GaryRudolph/N877RV/electrical/electrical-Cables.pdf

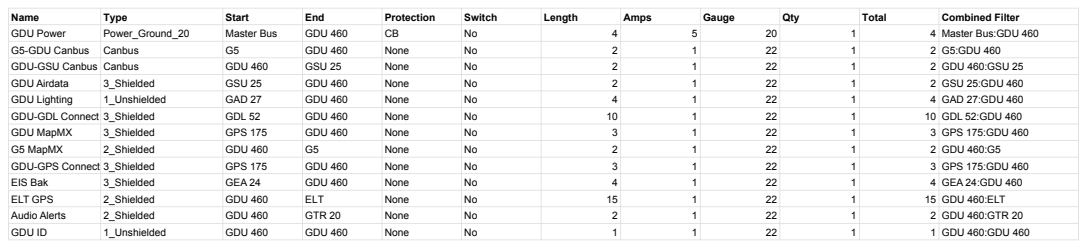
[picture p1: page 1]
Name; Type; Start; End; Protection; Switch; Length; Amps; Gauge; Qty; Total; Combined Filter; GDU Power; Power_Ground_20; Master Bus; GDU 460; 4 Master Bus:GDU 460; G5-GDU Canbus; Canbus; None; 2 G5:GDU 460; GDU-GSU Canbus Canbus; GSU 25; 2 GDU 460:GSU 25; GDU Airdata; 3_Shielded; 2 GSU 25:GDU 460; GDU Lighting; 1_Unshielded; GAD 27; 4 GAD 27:GDU 460; GDU-GDL Connect 3_Shielded; GDL 52; 10 GDL 52:GDU 460; GDU MapMX; GPS 175; 3 GPS 175:GDU 460; G5 MapMX; 2_Shielded; 2 GDU 460:G5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

Name | Type | Start | End | Protection | Switch | Length | Amps | Gauge | Qty | Total | Combined Filter
G5 Power | Power_Ground_20 | Avionics Bus | G5 | CB | No | 4 | 5 | 20 | 1 | 4 | Avionics Bus:G5
GSA-G5 Canbus | Canbus | GSA 28 Pitch | G5 | None | No | 15 | 1 | 22 | 1 | 15 | GSA 28 Pitch:G5
G5-GDU Canbus | Canbus | G5 | GDU 460 | None | No | 2 | 1 | 22 | 1 | 2 | G5:GDU 460
G5 MapMX | 2_Shielded | GDU 460 | G5 | None | No | 2 | 1 | 22 | 1 | 2 | GDU 460:G5

Name | Type | Start | End | Protection | Switch | Length | Amps | Gauge | Qty | Total | Combined Filter
GSU 25 Power | Power_Ground_22 | Master Bus | GSU 25 | CB | No | 4 | 2 | 22 | 1 | 4 | Master Bus:GSU 25
GDU-GSU Canbus | Canbus | GDU 460 | GSU 25 | None | No | 2 | 1 | 22 | 1 | 2 | GDU 460:GSU 25
GSU-GTR Canbus | Canbus | GSU 25 | GTR 20 | None | No | 2 | 1 | 22 | 1 | 2 | GSU 25:GTR 20
GTP 59 Cable | 3_Shielded | GSU 25 | GTP 59 | None | No | 10 | 1 | 22 | 1 | 10 | GSU 25:GTP 59
TX Airdata | 2_Shielded | GSU 25 | GTX 320 | None | No | 3 | 1 | 22 | 1 | 3 | GSU 25:GTX 320
GDU Airdata | 3_Shielded | GSU 25 | GDU 460 | None | No | 2 | 1 | 22 | 1 | 2 | GSU 25:GDU 460

Name | Type | Start | End | Protection | Switch | Length | Amps | Gauge | Qty | Total | Combined Filter
GSA 28 Roll Power | Power_Ground_18 | Avionics Bus | GSA 28 Roll [1] | CB | No | 15 | 5 | 18 | 1 | 15 | Avionics Bus:GSA 28 Roll
GSA 28 Pitch PowerPower_Ground_18 | | Avionics Bus | GSA 28 Pitch [2] | CB | No | 15 | 5 | 18 | 1 | 15 | Avionics Bus:GSA 28 Pitch
GMU-GSA Canbus | Canbus | GMU 11 | GSA 28 Pitch | None | No | 3 | 1 | 22 | 1 | 3 | GMU 11:GSA 28 Pitch
GSA-G5 Canbus | Canbus | GSA 28 Pitch | G5 | None | No | 15 | 1 | 22 | 1 | 15 | GSA 28 Pitch:G5
GAD27-GSA CanbusCanbus | | GAD 27 | GSA 28 Roll | None | No | 15 | 1 | 22 | 1 | 15 | GAD 27:GSA 28 Roll
CWS Disconnect | 1_Unshielded | Panel | GSA 28 | None | No | 10 | 1 | 22 | 2 | 20 | Panel:GSA 28

Name | Type | Start | End | Protection | Switch | Length | Amps | Gauge | Qty | Total | Combined Filter
GMU 11 Power | Power_Ground_22 | Master Bus | GMU 11 [1] | CB | No | 15 | 2 | 22 | 1 | 15 | Master Bus:GMU 11
GMU-GSA Canbus | Canbus | GMU 11 | GSA 28 Pitch | None | No | 3 | 1 | 22 | 1 | 3 | GMU 11:GSA 28 Pitch

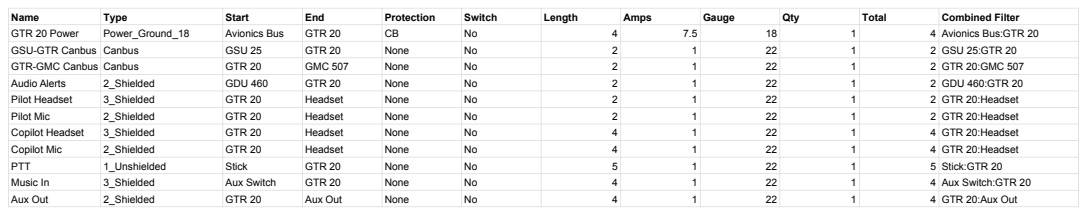
[picture p2: page 6]
Name; Type; Start; End; Protection; Switch; Length; Amps; Gauge; Qty; Total; Combined Filter; GTR 20 Power; Power_Ground_18; Avionics Bus; GTR 20; 4 Avionics Bus:GTR 20; GSU-GTR Canbus Canbus; GSU 25; None; 2 GSU 25:GTR 20; GTR-GMC Canbus Canbus; GMC 507; 2 GTR 20:GMC 507; Audio Alerts; 2_Shielded; GDU 460; 2 GDU 460:GTR 20; Pilot Headset; 3_Shielded; Headset; 2 GTR 20:Headset; Pilot Mic; Copilot Headset; 4 GTR 20:Headset; Copilot Mic; PTT; 1_Unshielded; Stick; 5 Stick:GTR 20; Music In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

Name | Type | Start | End | Protection | Switch | Length | Amps | Gauge | Qty | Total | Combined Filter
GMC 507 Power | Power_Ground_22 | Avionics Bus | GMC 507 | Fuse | No | 2 | 1 | 22 | 1 | 2 | Avionics Bus:GMC 507
GTR-GMC Canbus | Canbus | GTR 20 | GMC 507 | None | No | 2 | 1 | 22 | 1 | 2 | GTR 20:GMC 507
GMC-GAD29 CanbusCanbus | | GMC 507 | GAD 29 | None | No | 2 | 1 | 22 | 1 | 2 | GMC 507:GAD 29
GMC Light | 1_Unshielded | GAD 27 | GMC 507 | None | No | 3 | 1 | 22 | 1 | 3 | GAD 27:GMC 507

3 Avionics Bus:GPS 175
3 GPS 175:GDU 460
3 GAD 27:GPS 175

Name | Type | Start | End | Protection | Switch | Length | Amps | Gauge | Qty | Total | Combined Filter
GAD 29 Power | Power_Ground_20 | Avionics Bus | GAD 29 | CB | No | 3 | 5 | 20 | 1 | 3 | Avionics Bus:GAD 29
GMC-GAD29 CanbusCanbus | | GMC 507 | GAD 29 | None | No | 2 | 1 | 22 | 1 | 2 | GMC 507:GAD 29
GAD29-GEA CanbusCanbus | | GAD 29 | GEA 24 | None | No | 2 | 1 | 22 | 1 | 2 | GAD 29:GEA 24
ARINC | Cat_5 | GPS 175 | GAD 29 | None | No | 2 | 1 | 22 | 2 | 4 | GPS 175:GAD 29

Name | Type | Start | End | Protection | Switch | Length | Amps | Gauge | Qty | Total | Combined Filter
GTX 320 Power | Power_Ground_18 | Avionics Bus | GTX 320 | CB | No | 2 | 3 | 18 | 1 | 2 | Avionics Bus:GTX 320
TX Airdata | 2_Shielded | GSU 25 | GTX 320 | None | No | 3 | 1 | 22 | 1 | 3 | GSU 25:GTX 320
GTX Light | 1_Unshielded | GAD 27 | GTX 320 | None | No | 3 | 1 | 22 | 1 | 3 | GAD 27:GTX 320
Grey Code | 10_Shielded | Alt Encoder | GTX 320 | None | No | 2 | 1 | 22 | 1 | 2 | Alt Encoder:GTX 320

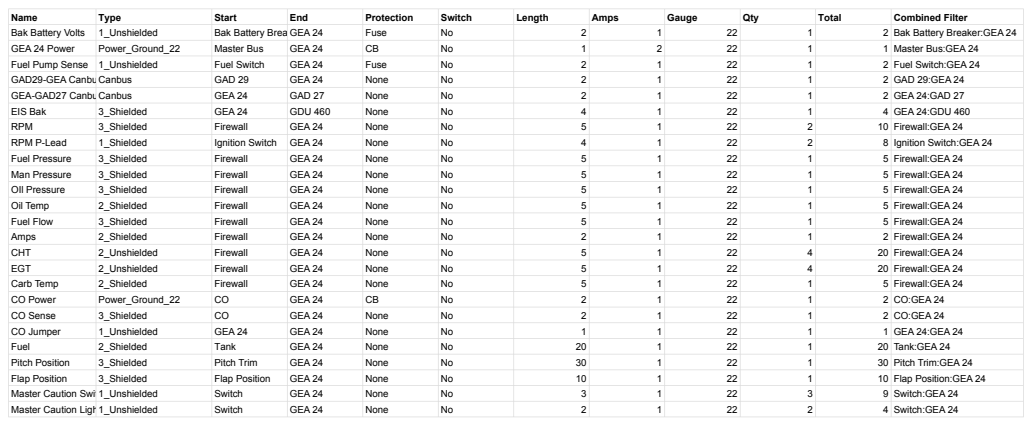
[picture p3: page 11]
Name; Type; Start; End; Protection; Switch; Length; Amps; Gauge; Qty; Total; Combined Filter; Bak Battery Volts; 1_Unshielded; Bak Battery Breaker GEA 24; Fuse; 2 Bak Battery Breaker:GEA 24; GEA 24 Power; Power_Ground_22; Master Bus; GEA 24; 1 Master Bus:GEA 24; Fuel Pump Sense 1_Unshielded; Fuel Switch; 2 Fuel Switch:GEA 24; GAD29-GEA CanbusCanbus; GAD 29; None; 2 GAD 29:GEA 24; GEA-GAD27 CanbusCanbus; GAD 27; 2 GEA 24:GAD 27; EIS Bak; 3_Shielded; GDU 460; 4 GEA 24:GDU 460; RPM; Firewall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

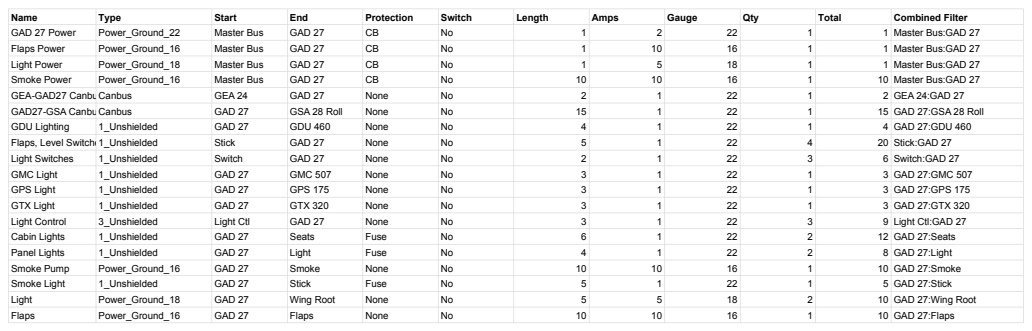
[picture p4: page 12]
Name; Type; Start; End; Protection; Switch; Length; Amps; Gauge; Qty; Total; Combined Filter; GAD 27 Power; Power_Ground_22; Master Bus; GAD 27; 1 Master Bus:GAD 27; Flaps Power; Power_Ground_16; Light Power; Power_Ground_18; Smoke Power; 10 Master Bus:GAD 27; GEA-GAD27 CanbusCanbus; GEA 24; None; 2 GEA 24:GAD 27; GAD27-GSA CanbusCanbus; GSA 28 Roll; 15 GAD 27:GSA 28 Roll; GDU Lighting; 1_Unshielded; GDU 460; 4 GAD 27:GDU 460; Flaps, Level Switches1_Unshielded; Stick; 20 Stick:GAD 27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

Name | Type | Start | End | Protection | Switch | Length | Amps | Gauge | Qty | Total | Combined Filter
GDL 52 Power | Power_Ground_20 | Avionics Bus | GDL 52 [1] | CB | No | 10 | 3 | 20 | 1 | 10 | Avionics Bus:GDL 52
GDU-GDL Connect | 3_Shielded | GDL 52 | GDU 460 | None | No | 10 | 1 | 22 | 1 | 10 | GDL 52:GDU 460
Siriux In | 3_Shielded | GDL 52 | Aux Switch | None | No | 15 | 1 | 22 | 1 | 15 | GDL 52:Aux Switch
GPS GDL Connect | 3_Shielded | GDL 52 | GPS 175 | None | No | 15 | 1 | 22 | 1 | 15 | GDL 52:GPS 175
