GaryRudolph/N877RV/electrical/electrical.pdf

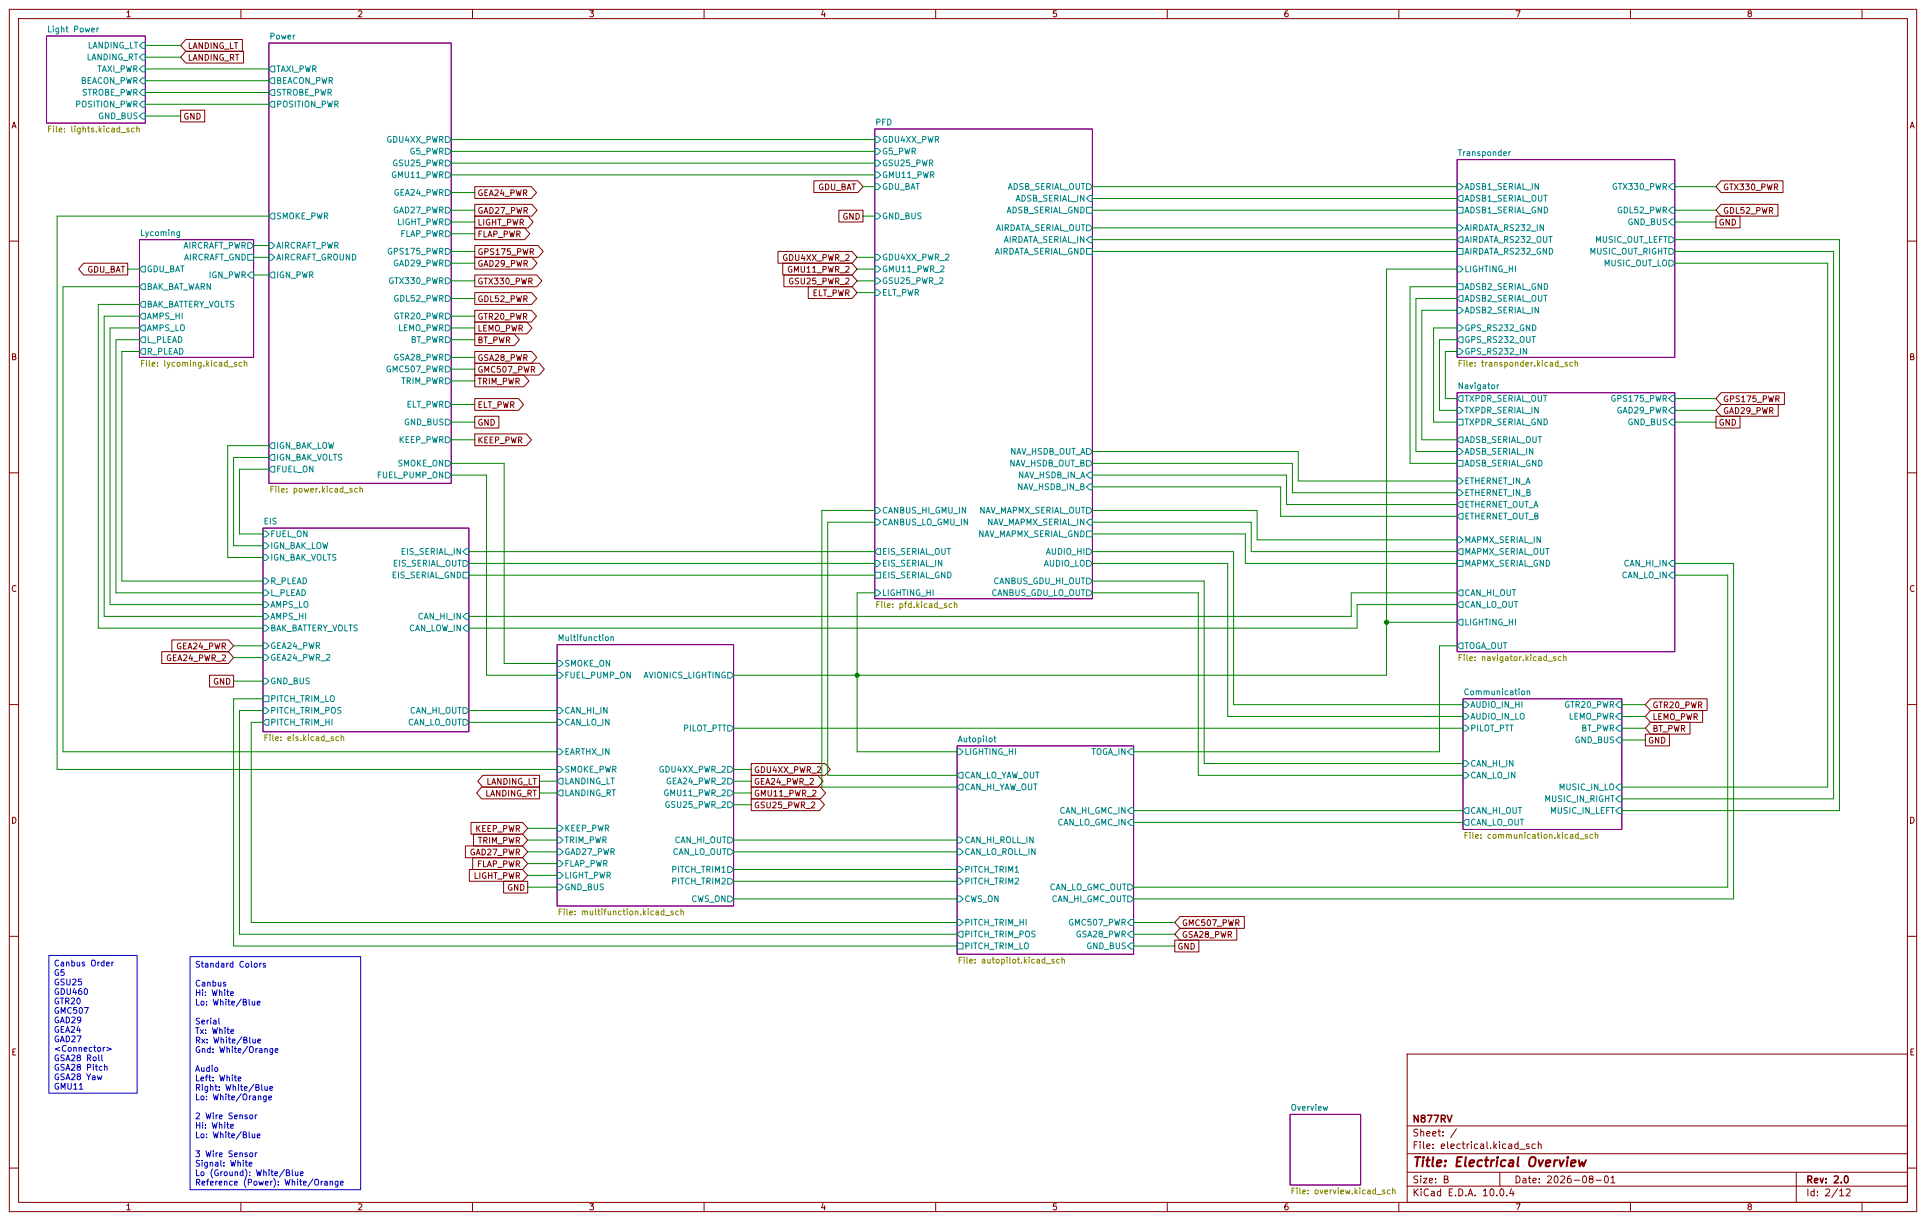
[picture p5: page 1]

Light Power File: lights.kicad_sch
LANDING_LT LANDING_RT POSITION_PWR

Lo (Ground): White/Blue Reference (Power): White/Orange Canbus Order G5GSU25 GDU460 GTR20 GMC507 GAD29 GEA24 GAD27 <Connector>

Standard Colors Canbus Hi: White

Lo: White/Blue Serial Tx: White Rx: White/Blue Gnd: White/Orange

Audio
Left: White Right: White/Blue

Lo: White/Orange 2 Wire Sensor Hi: White

Lo: White/Blue 3 Wire Sensor Signal: White

Size: B | Rev: 2.0
KiCad E.D.A. 10.0.4 | Id: 2/12

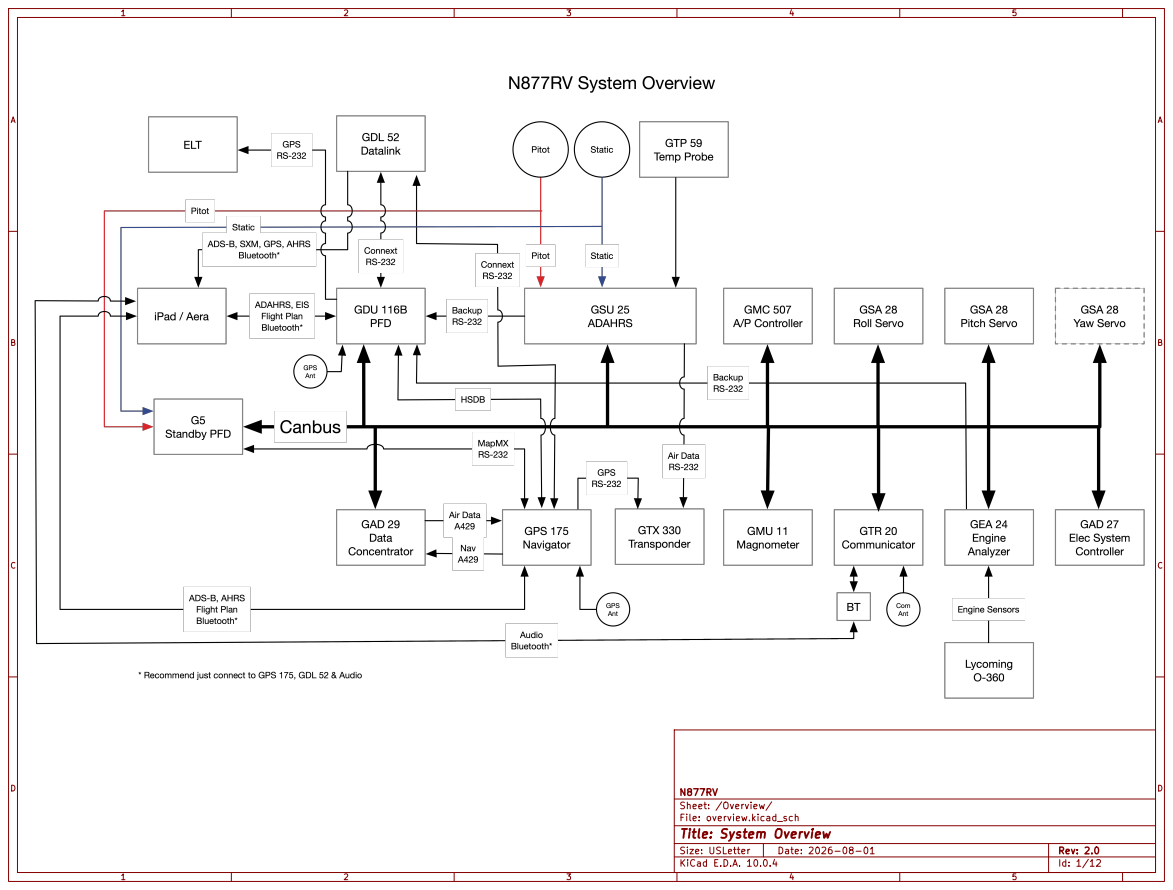
[picture p6: page 2]

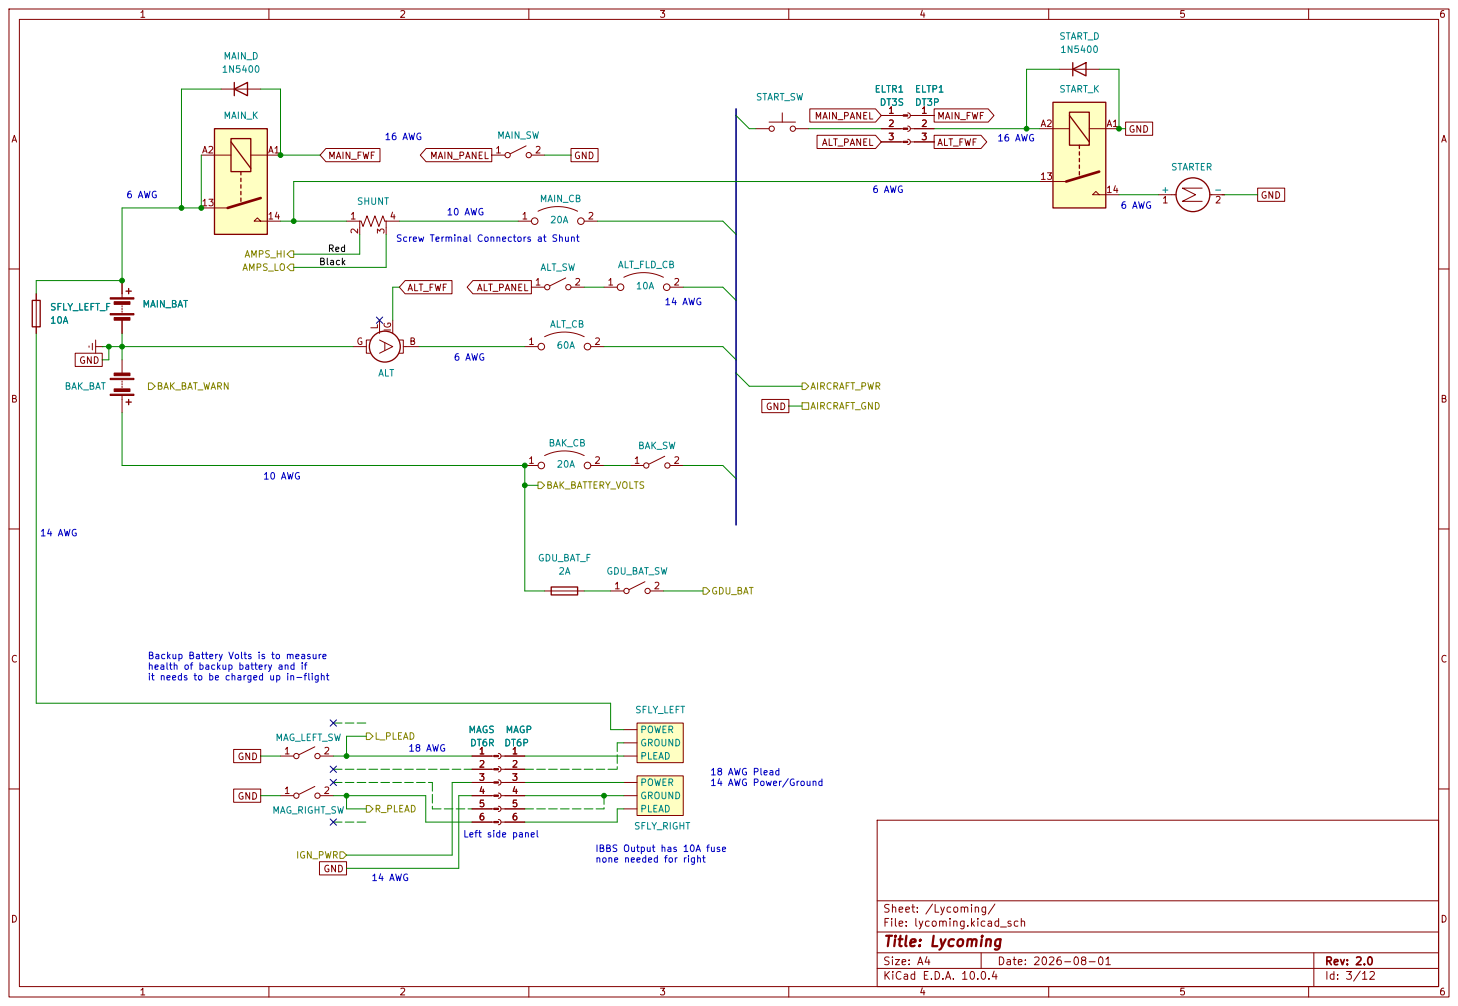
[picture p7: page 3]

Screw Terminal Connectors at Shunt

Backup Battery Volts is to measure health of backup battery and if

IBBS Output has 10A fuse none needed for right

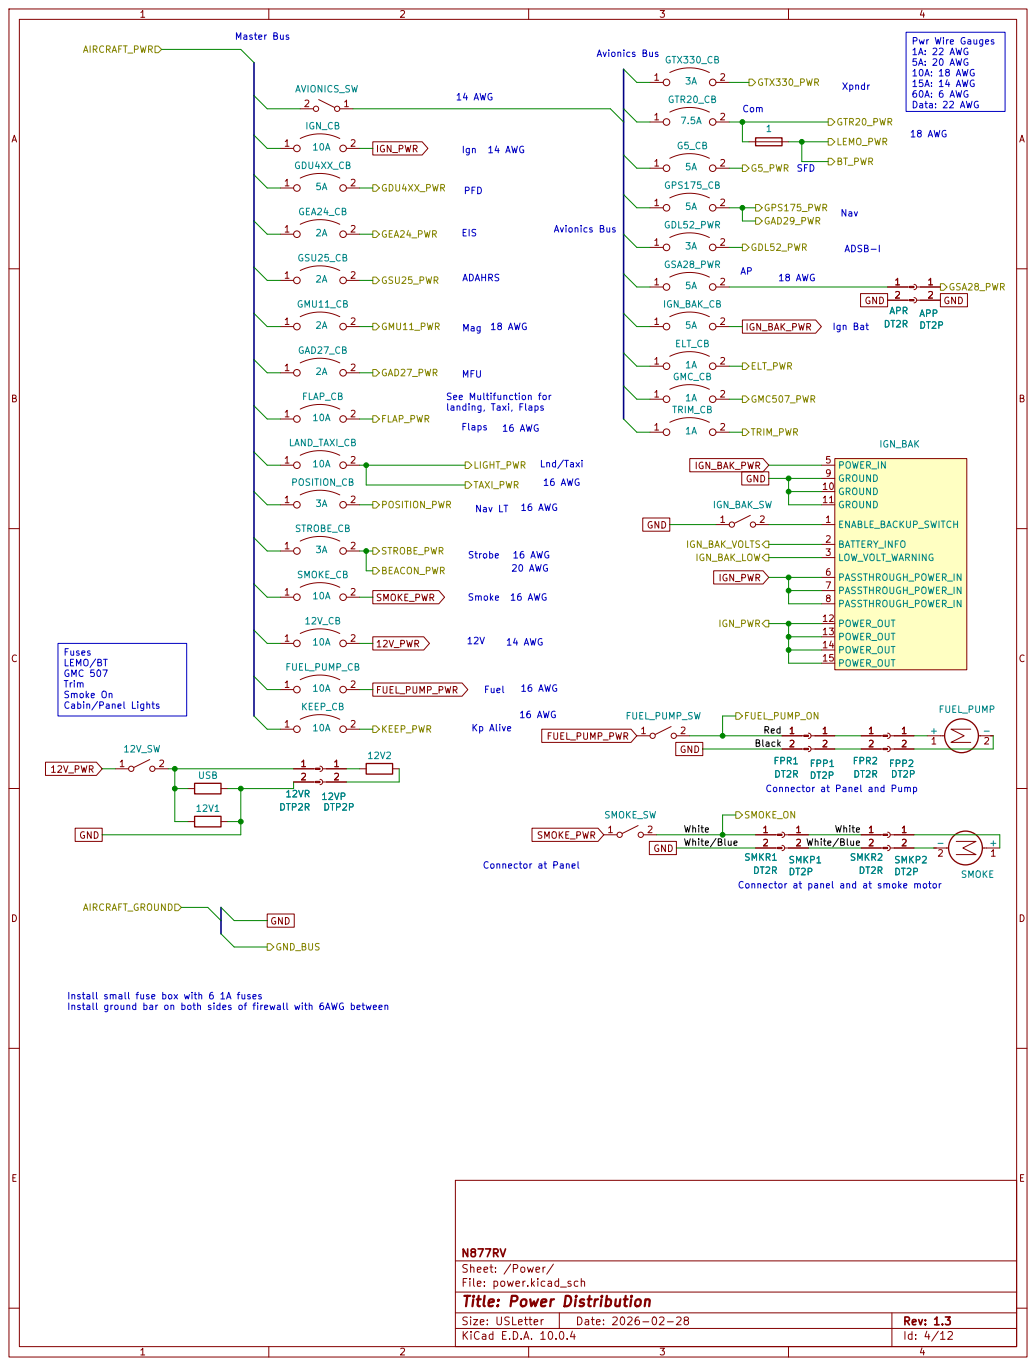
[picture p8: page 4]

Pwr Wire Gauges 1A: 22 AWG

GSU25_PWR
Kp Alive Connector at Panel 16 AWG
TAXI_PWR

Trim
Smoke On Cabin/Panel Lights

Connector at Panel and Pump

Install small fuse box with 6 1A fuses
Install ground bar on both sides of firewall with 6AWG between

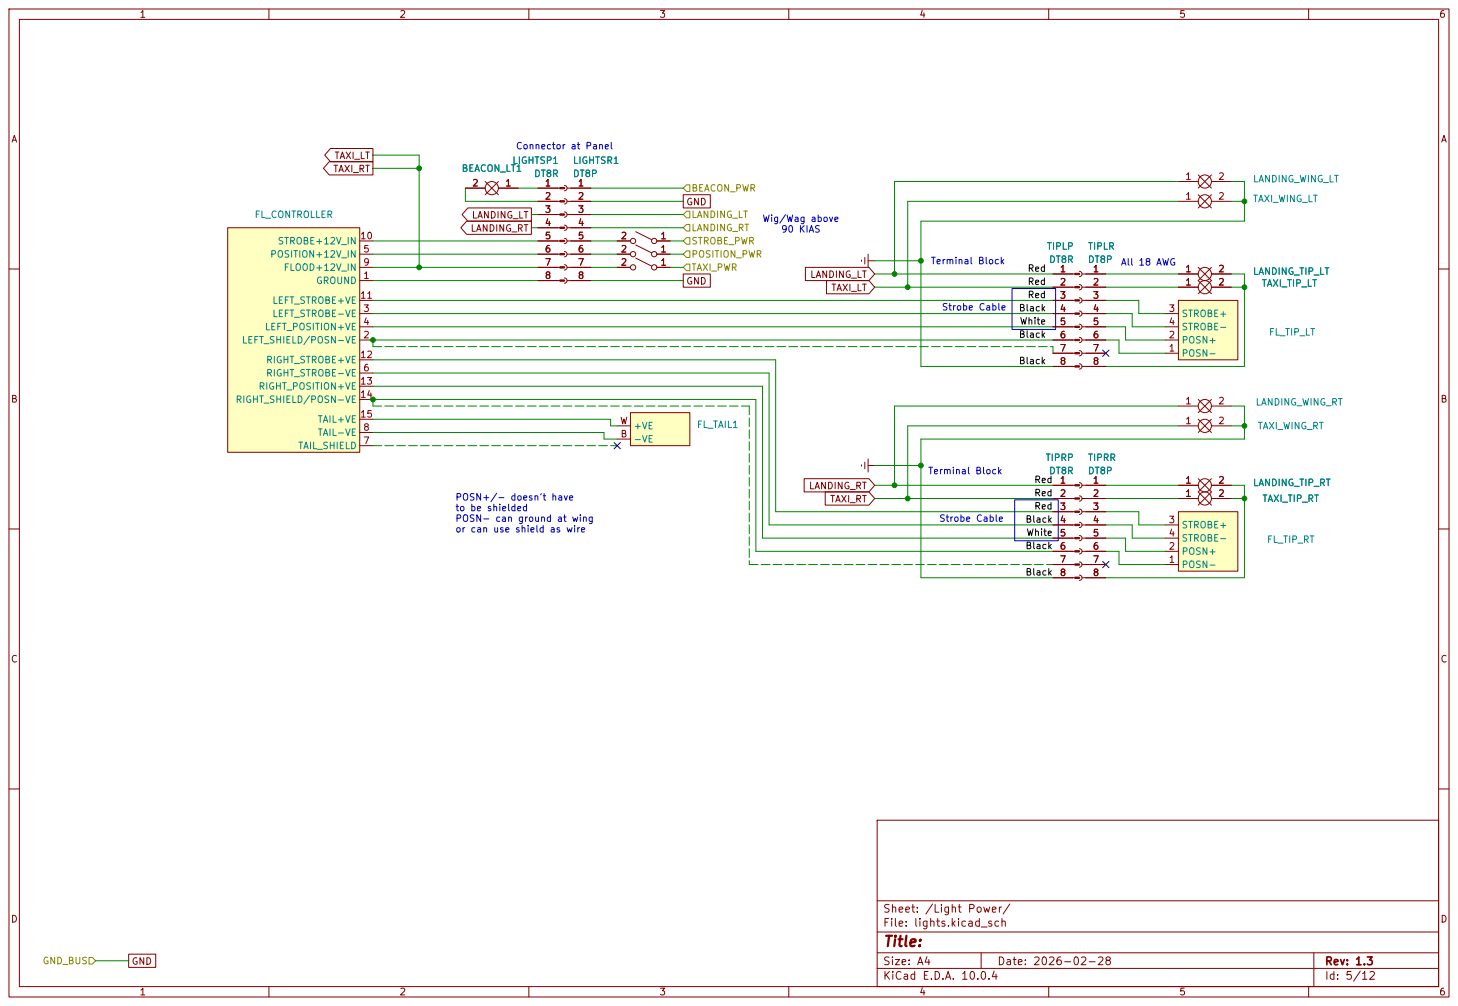
[picture p9: page 5]

LEFT_STROBE+VE 11 RIGHT_STROBE+VE 12 RIGHT_POSITION+VE 13 RIGHT_SHIELD/POSN-VE 14

Terminal Block POSN+/- doesn't have

to be shielded POSN- can ground at wing

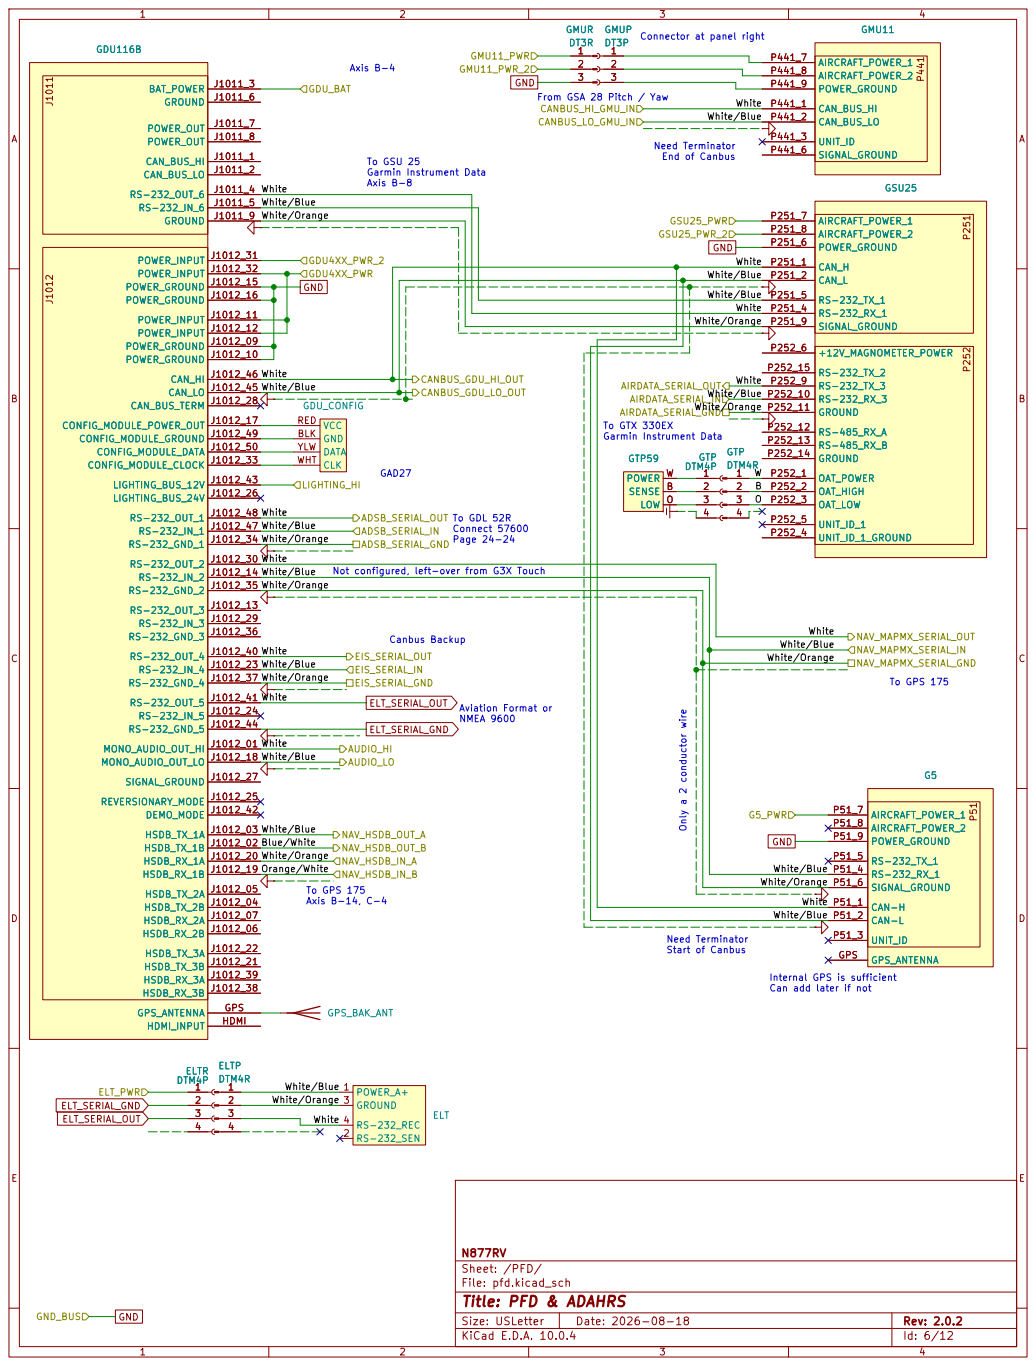
[picture p10: page 6]

To GSU 25 Garmin Instrument Data

ELT_SERIAL_OUT White/Blue White White White/Blue

To GDL 52R
Connect 57600 Page 24-24
White/Orange White White/BlueWhite White/Blue

Internal GPS is sufficient Can add later if not Canbus Backup Not configured, left-over from G3X Touch

Aviation Format or NMEA 9600

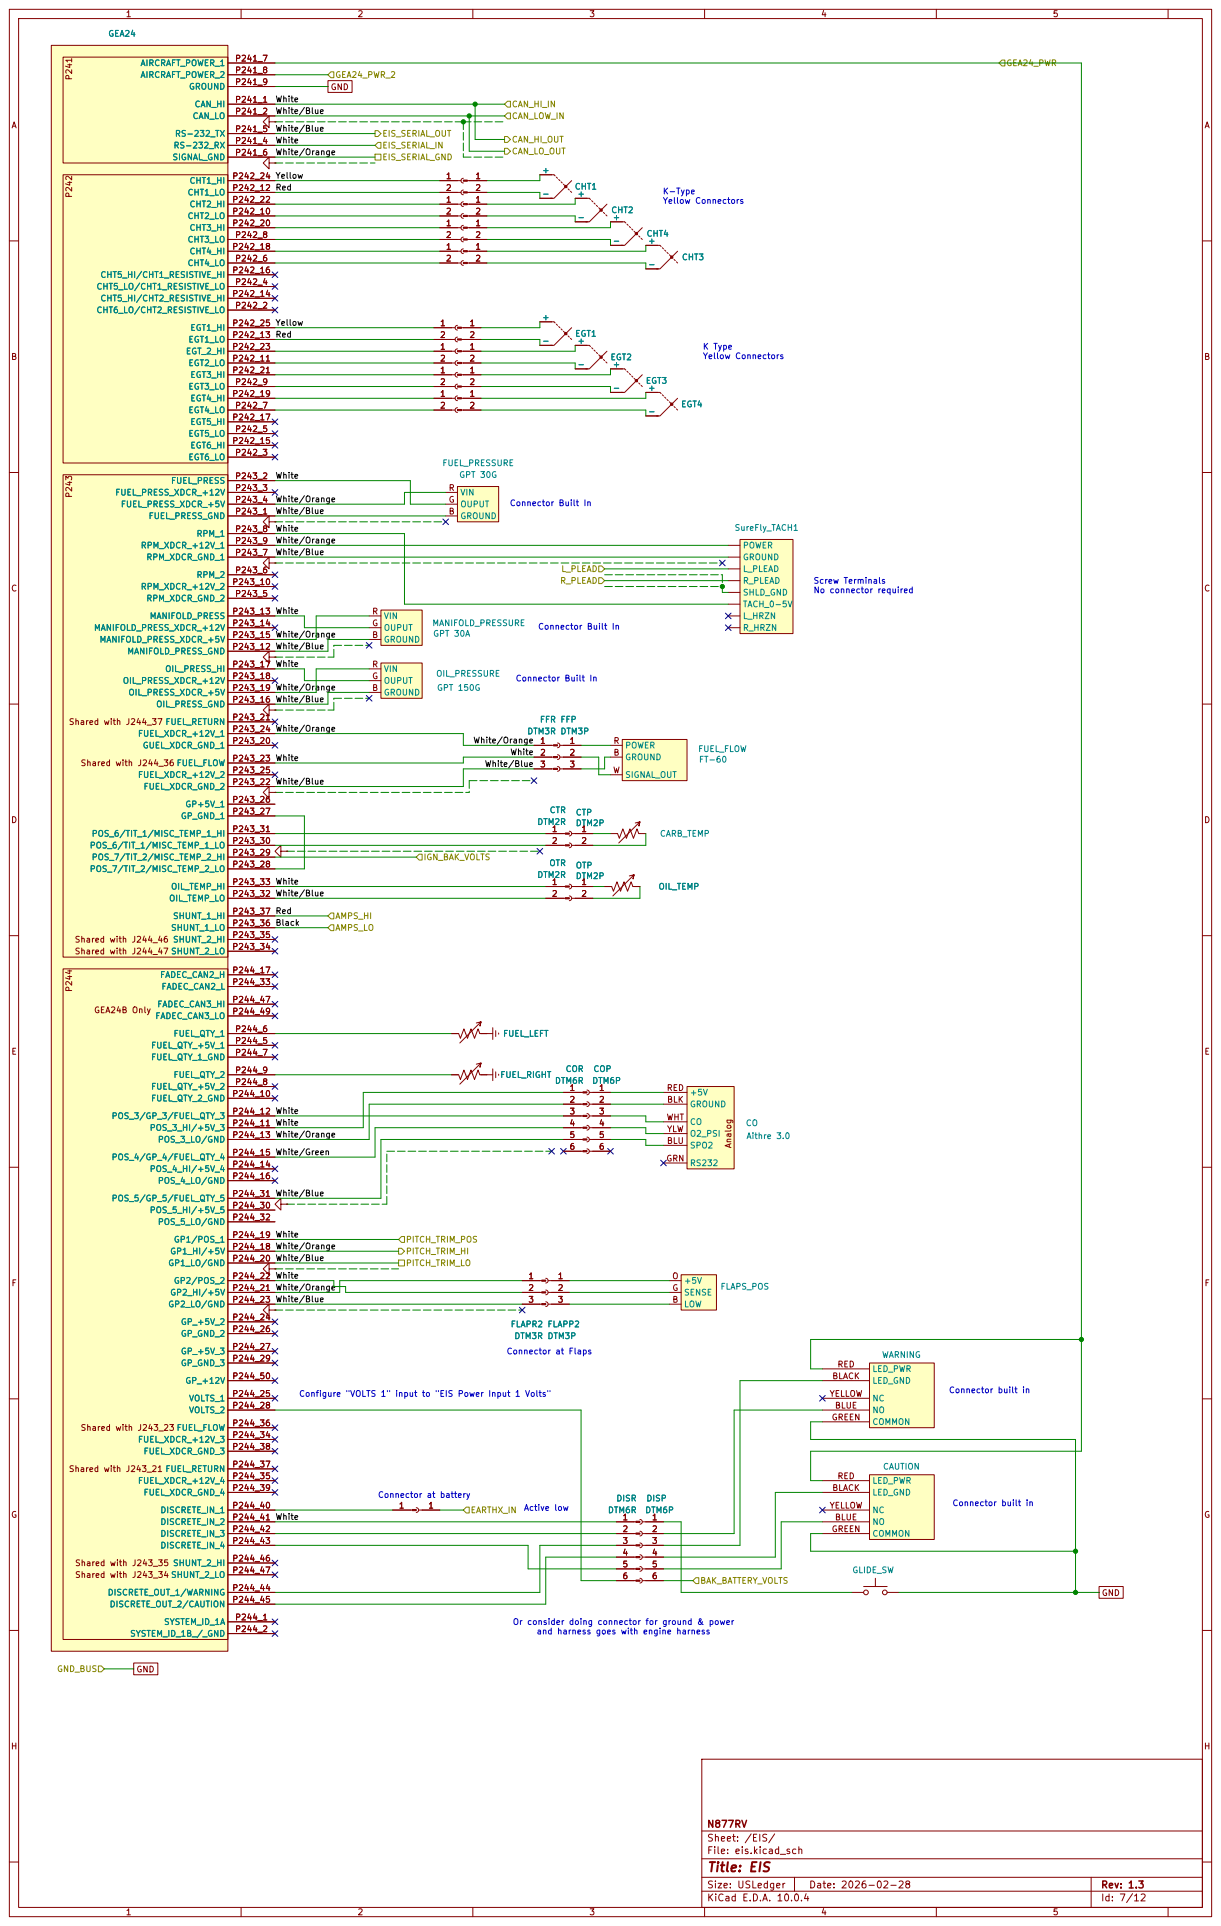
[picture p11: page 7]

L_PLEAD | WARNING P241 P242 P243 P244 Shared with J243_35

Yellow White/Orange White
White/Blue
White/Blue White Red

White/Blue White White/Orange White

White/Blue White White/Orange

White/Blue White Red Black White White/Orange

White White/Orange White
White/Orange

Connector built in Connector at battery

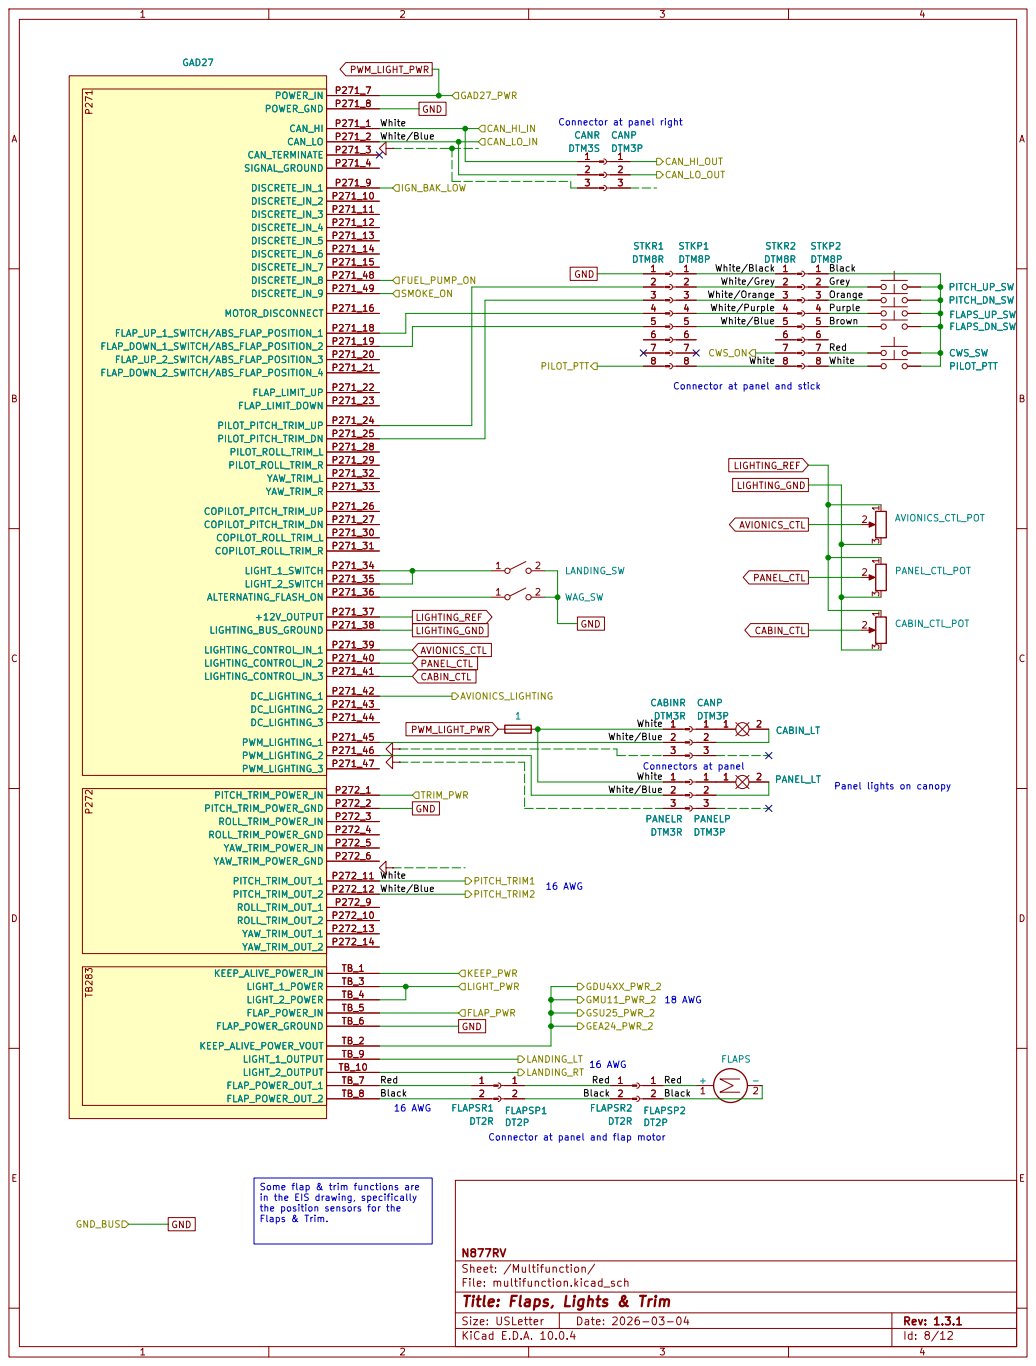
[picture p12: page 8]

Connector at panel right Connectors at panel 16 AWG
White

Connector at panel and stick

Some flap & trim functions are
in the EIS drawing, specifically
the position sensors for the

Sheet: /Multifunction/
File: multifunction.kicad_sch
Title: Flaps, Lights & Trim

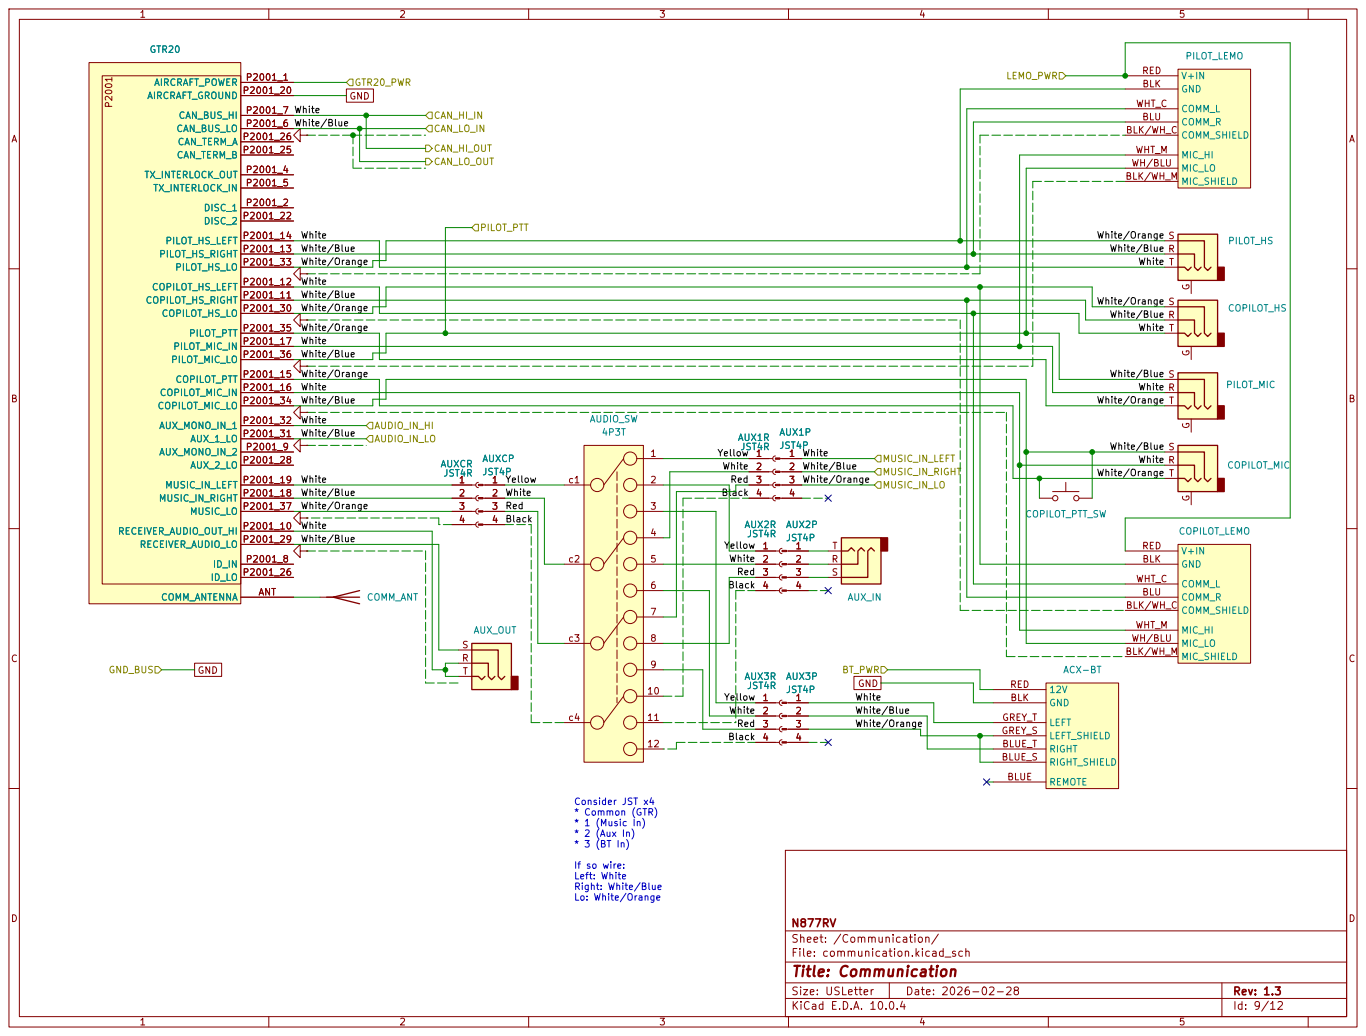
[picture p13: page 9]

White/Blue White White/Blue White White White/Orange

White/Blue White White White/Orange

White/Orange White White/Orange

COMM_L WHT_C MIC_HI WHT_M COMM_R BLU

COMM_SHIELD BLK/WH_C MIC_SHIELD BLK/WH_M

* Common (GTR) * 1 (Music In) * 2 (Aux In) * 3 (BT

If so wire: Left: White Right: White/Blue

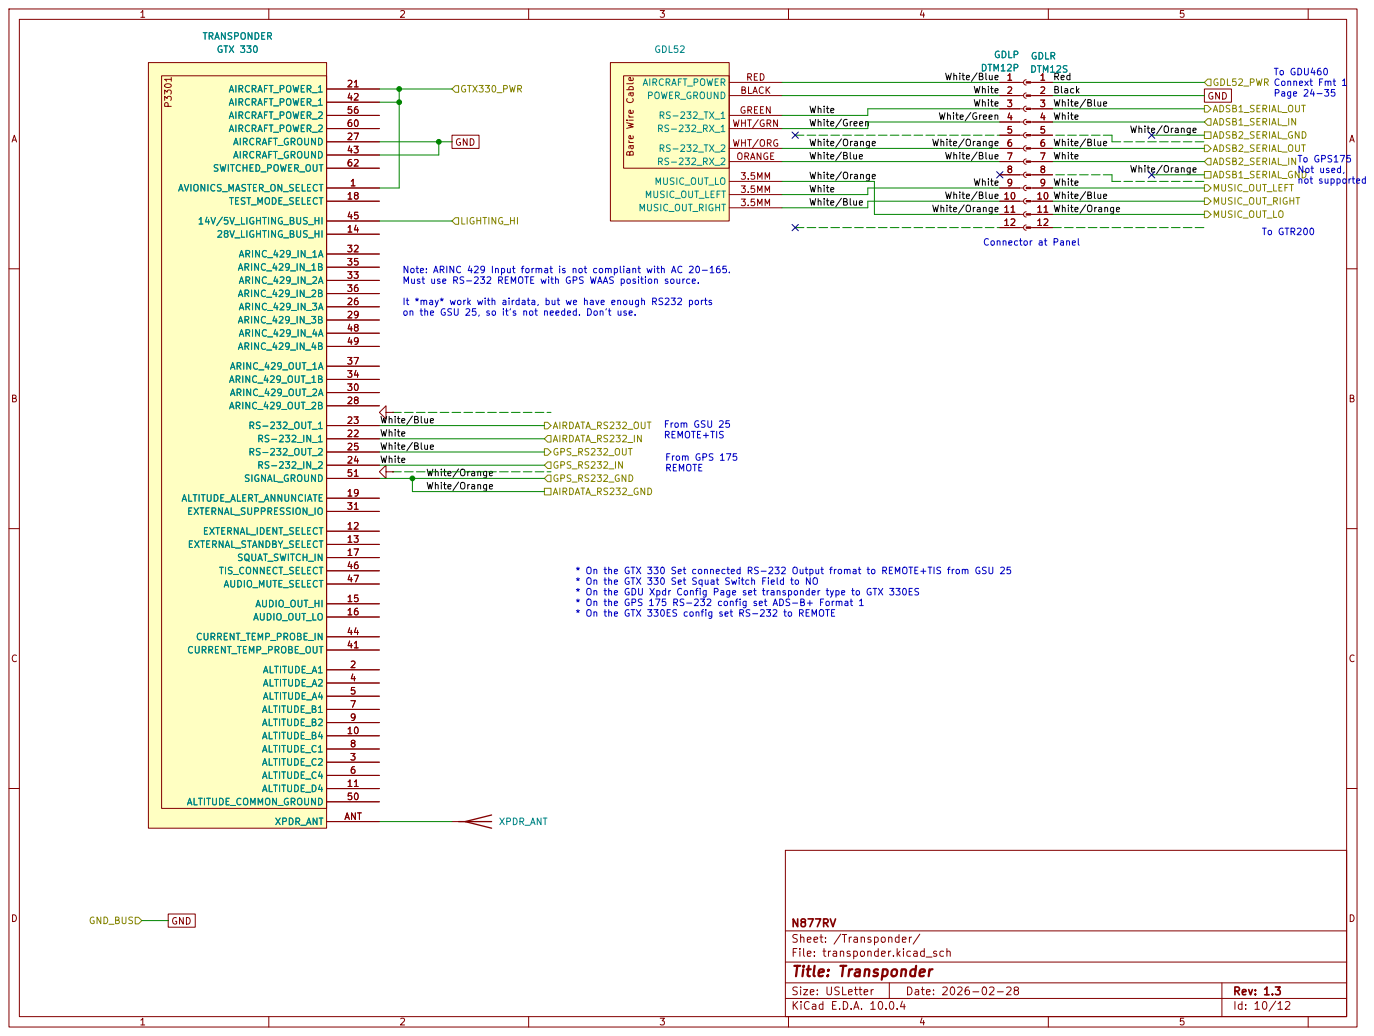
[picture p14: page 10]

To GPS175 Not used, not supported Connector at Panel TRANSPONDER
GTX 330

To GDU460 Connext Fmt 1 Page 24-35

White/Blue Note: ARINC 429 Input format is not compliant with AC 20-165. Must use RS-232 REMOTE with GPS WAAS position source.

White/Orange White White White White/Blue White White/Blue

White/Green
White/Blue White White/Orange White/Blue
White/Blue
White/Orange

White/Orange White White/Blue

* On the GTX 330 Set connected RS-232 Output fromat to REMOTE+TIS from GSU 25
* On the GTX 330 Set Squat Switch Field to NO
* On the GDU Xpdr Config Page set transponder type to GTX 330ES
* On the GPS 175 RS-232 config set ADS-B+ Format 1
* On the GTX 330ES config set RS-232 to REMOTE

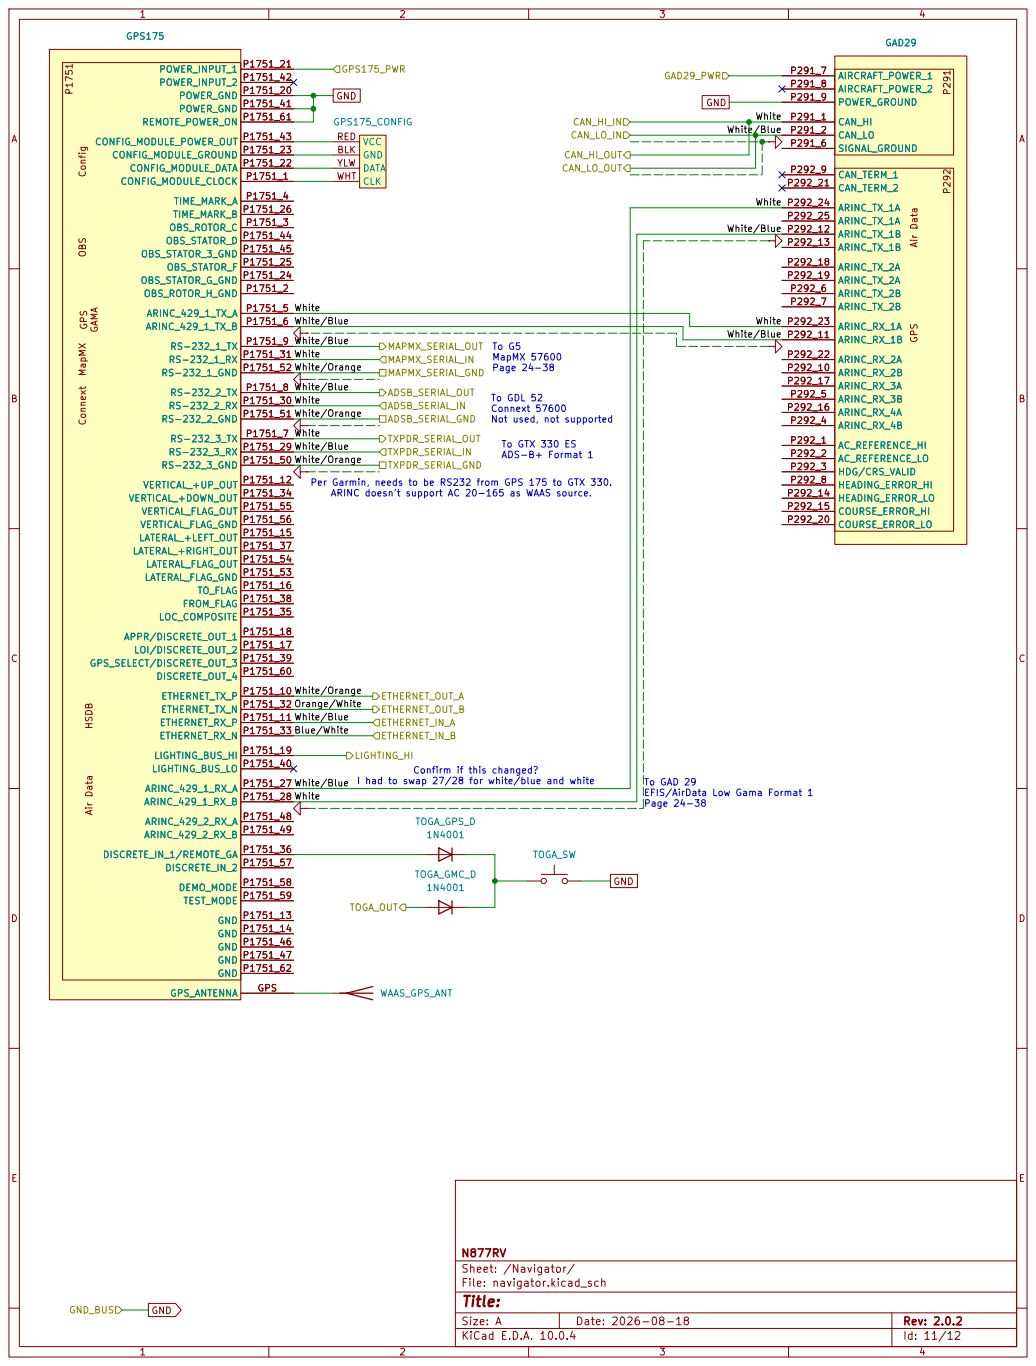
[picture p15: page 11]

GND
White/Orange White White/Orange White White/Blue

MAPMX_SERIAL_IN MAPMX_SERIAL_GND MAPMX_SERIAL_OUT ETHERNET_OUT_A ETHERNET_IN_A ETHERNET_IN_B
White/Orange White Blue/White

White/Blue White Per Garmin, needs to be RS232 from GPS 175 to GTX 330. ARINC doesn't support AC 20-165 as WAAS source. To G5 MapMX 57600 Page 24-38 Confirm if this changed?

To GDL 52 Connext 57600 Not used, not supported

I had to swap 27/28 for white/blue and white

To GAD 29
EFIS/AirData Low Gama Format 1 Page 24-38

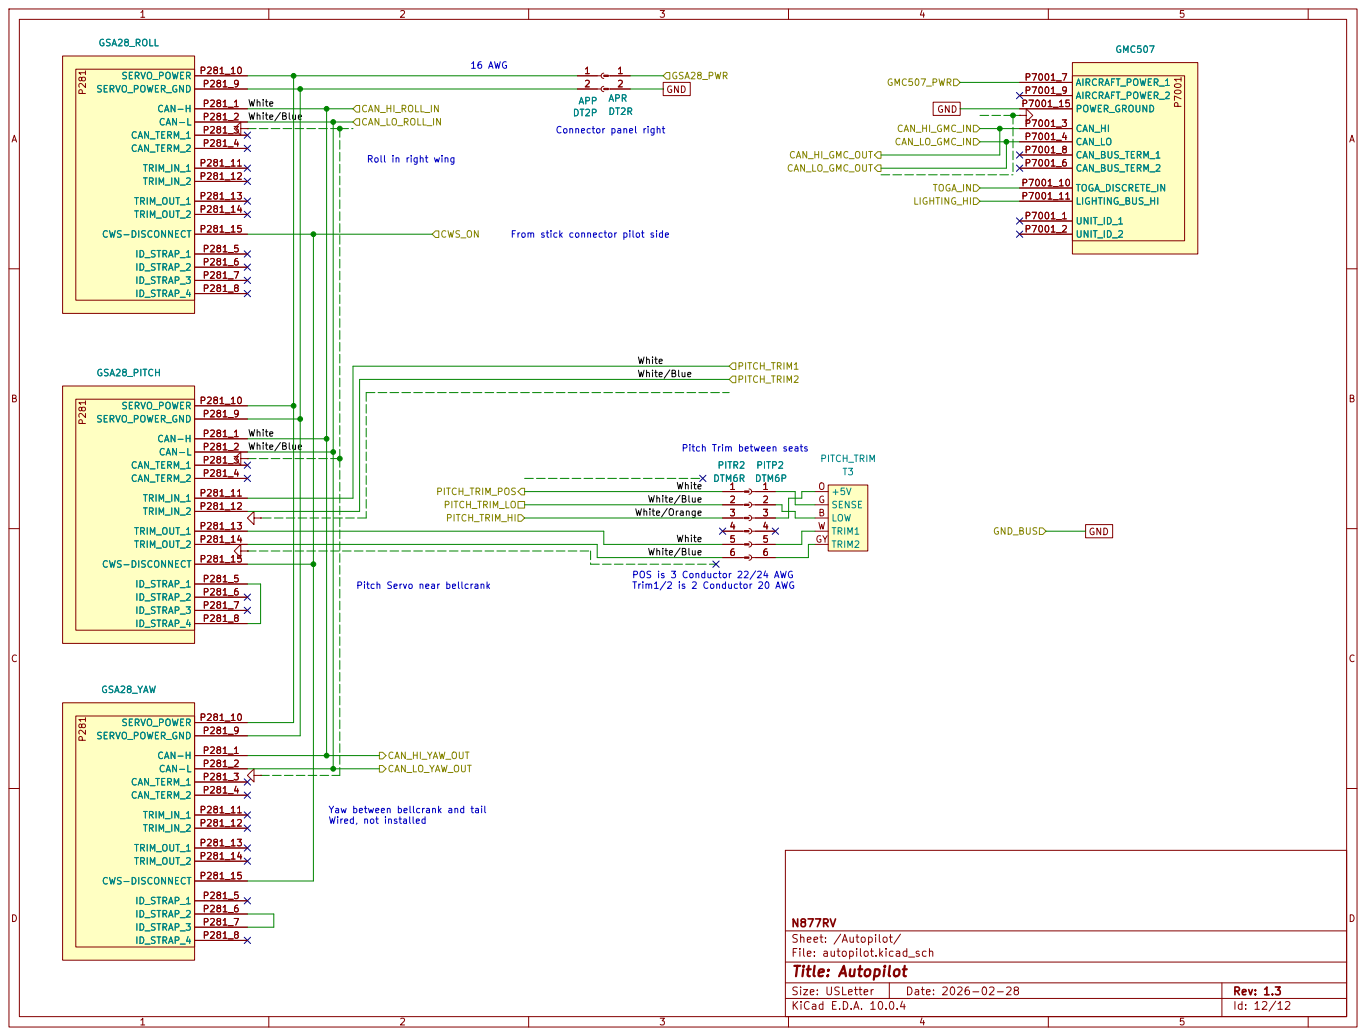
[picture p16: page 12]

Connector panel right 16 AWG

White/Blue Pitch Servo near bellcrank Yaw between bellcrank and tail Wired, not installed
