GaryRudolph/N877RV/electrical/electrical-g3x.pdf

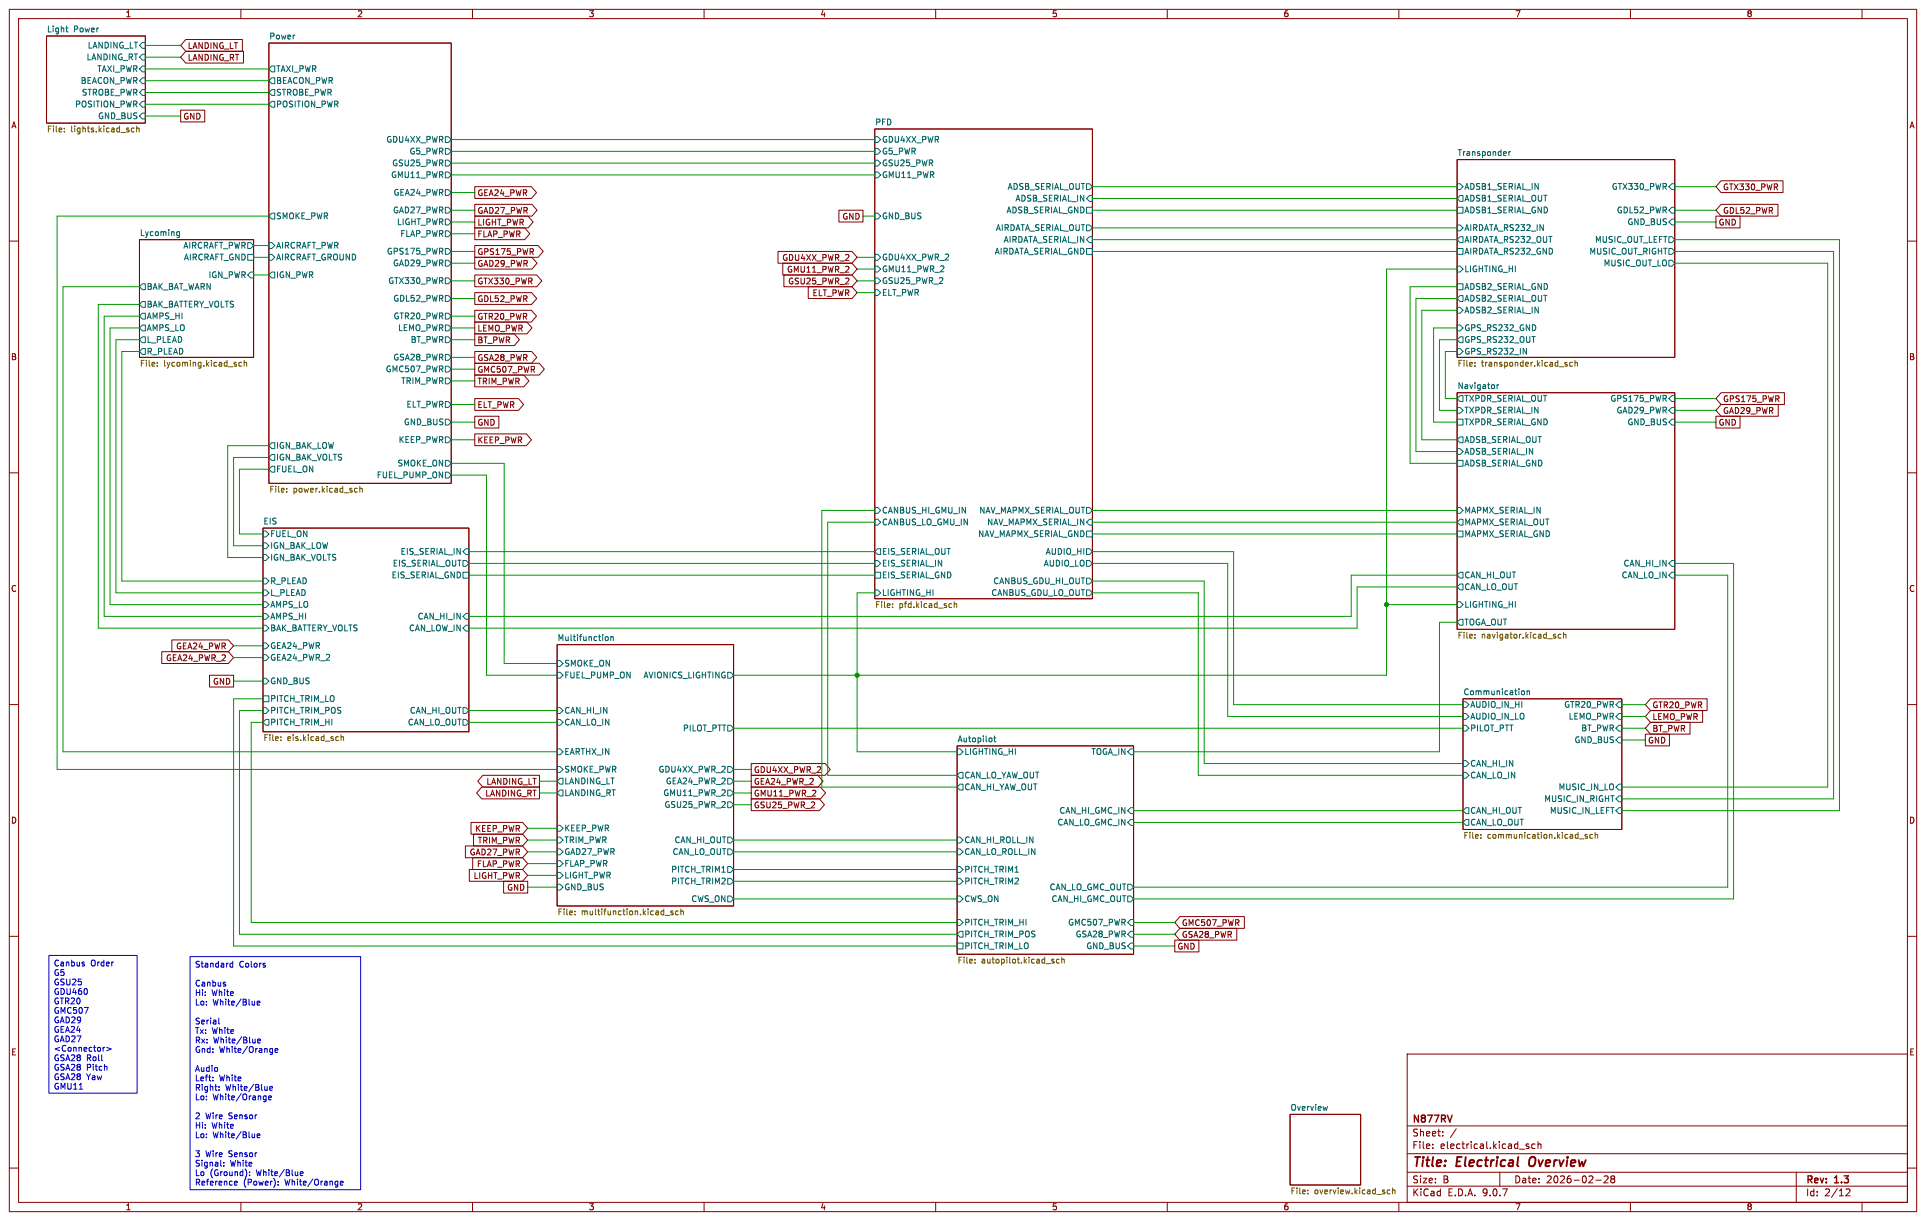
[picture p17: page 1]

Light Power File: lights.kicad_sch

Standard Colors Canbus Hi: White

Lo: White/Blue Serial Tx: White Rx: White/Blue Gnd: White/Orange Audio

Left: White Right: White/Blue

2 Wire Sensor Hi: White

3 Wire Sensor Signal: White

Id: 2/12 Title: Electrical Overview

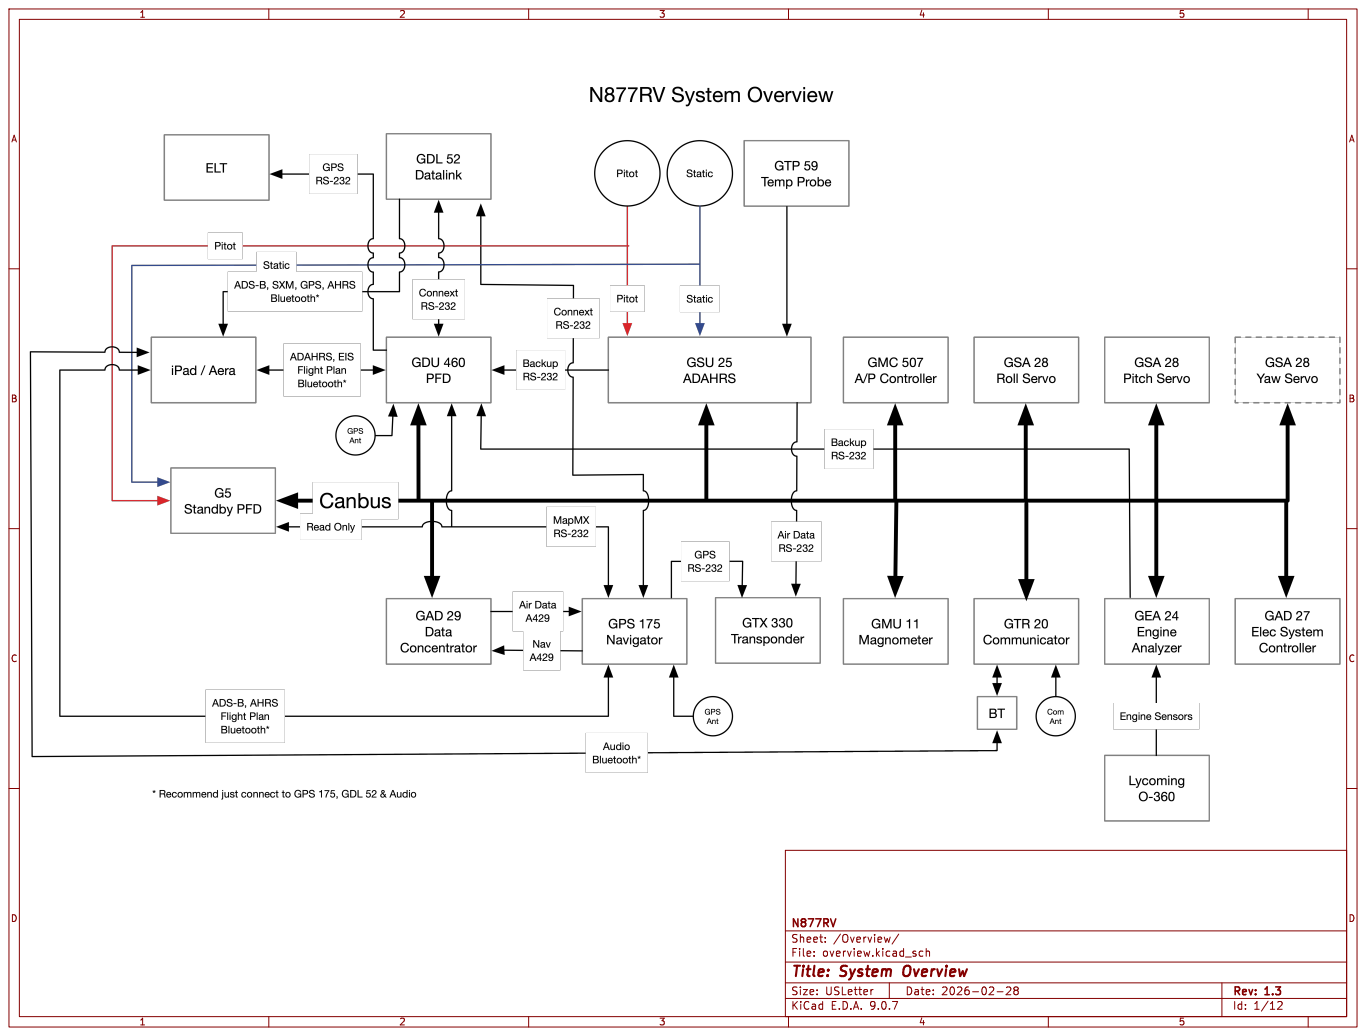
[picture p18: page 2]

File: overview.kicad_sch Sheet: /Overview/ N877RV

Id: 1/12 Title: System Overview

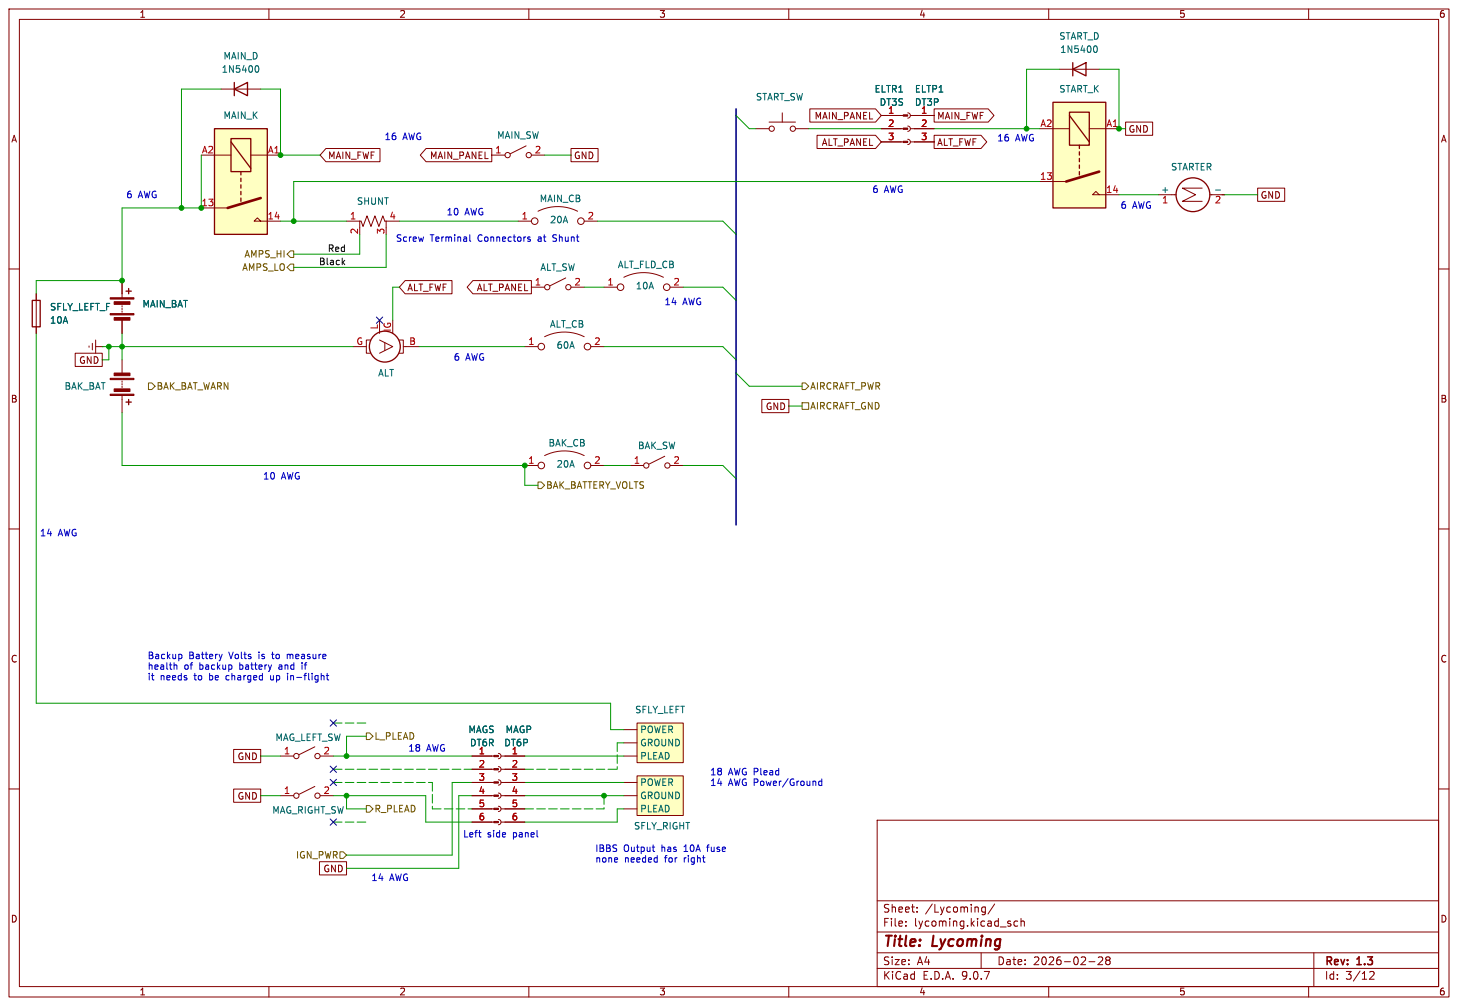
[picture p19: page 3]

Backup Battery Volts is to measure
health of backup battery and if

SFLY_LEFT
File: lycoming.kicad_sch Sheet: /Lycoming/ POWER GROUND

Left side panel 18 AWG

IBBS Output has 10A fuse
none needed for right

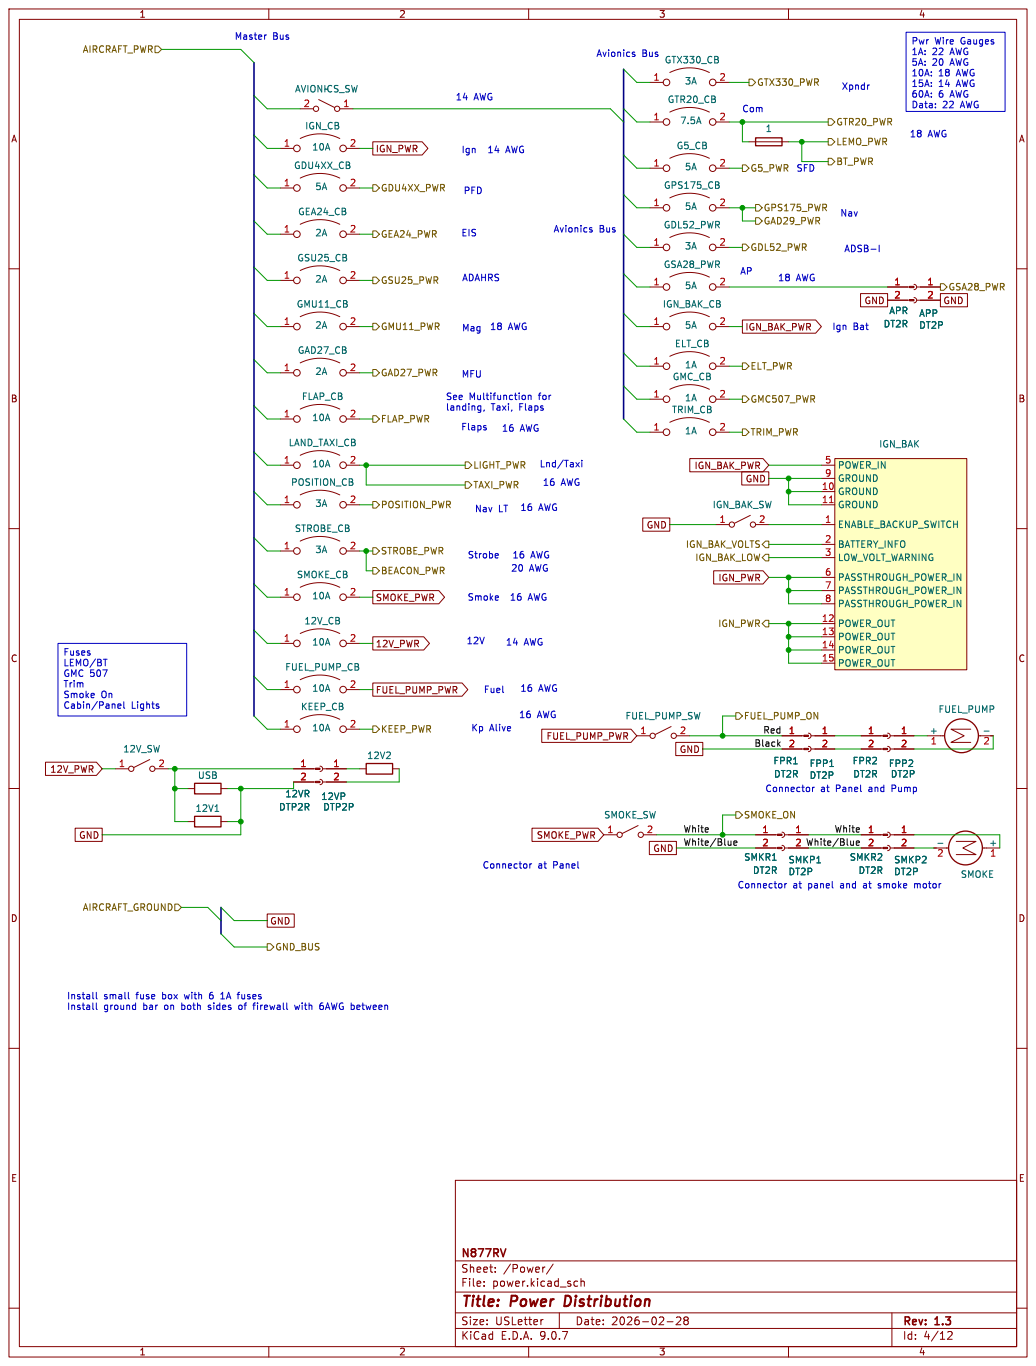
[picture p20: page 4]

Pwr Wire Gauges 1A: 22 AWG

Ign Bat Nav LT

File: power.kicad_sch Sheet: /Power/ N877RV

Id: 4/12 Title: Power Distribution

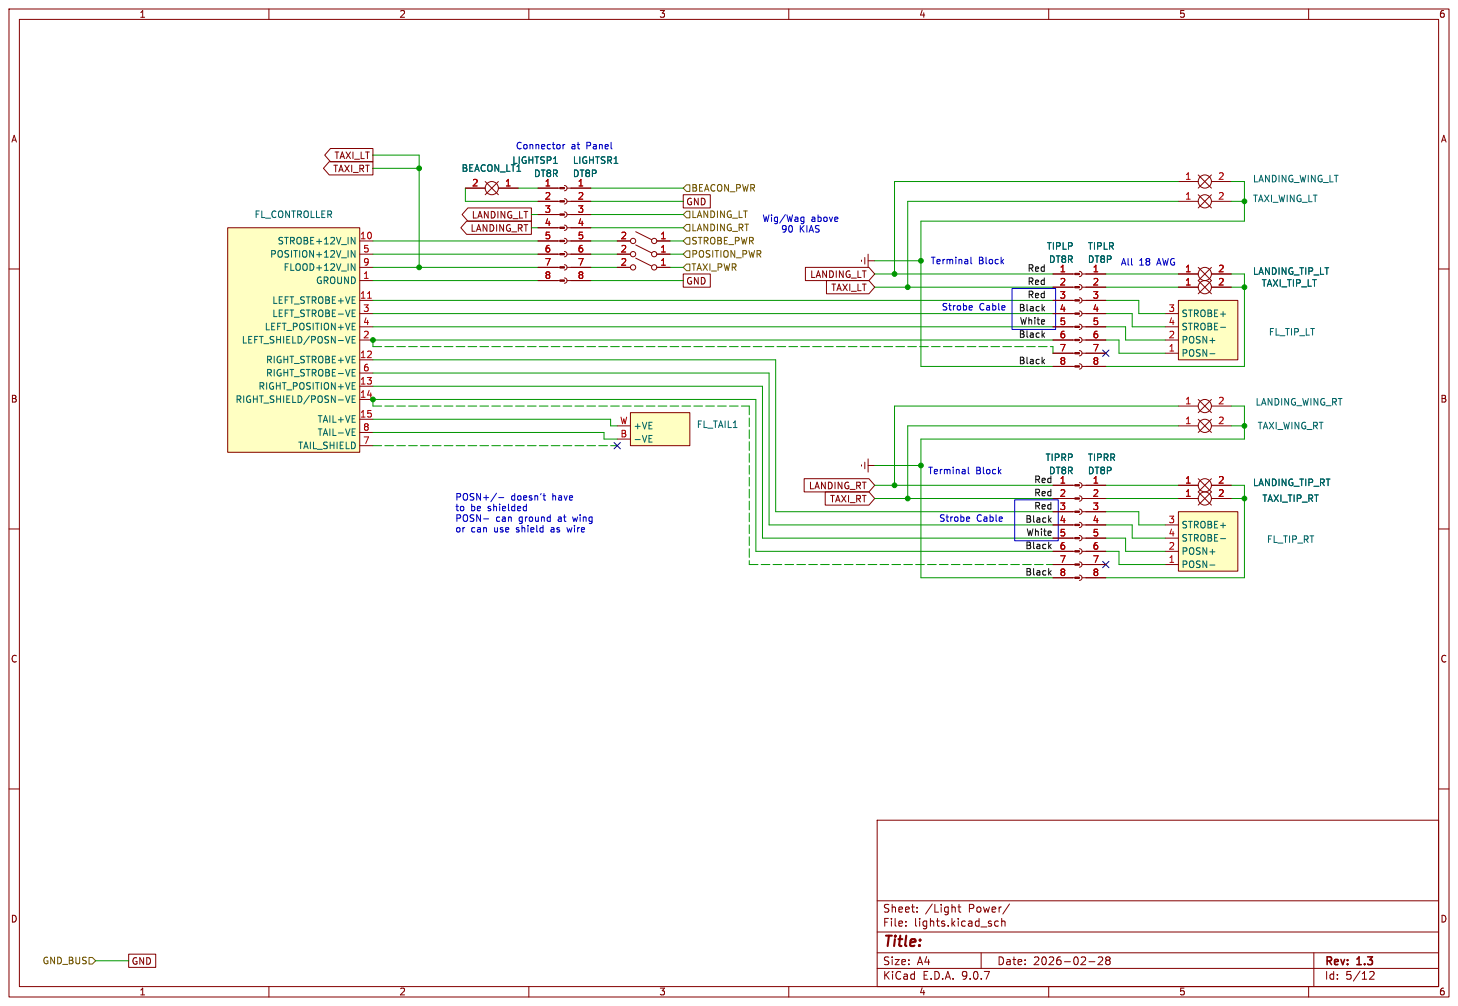
[picture p21: page 5]

to be shielded POSN- can ground at wing

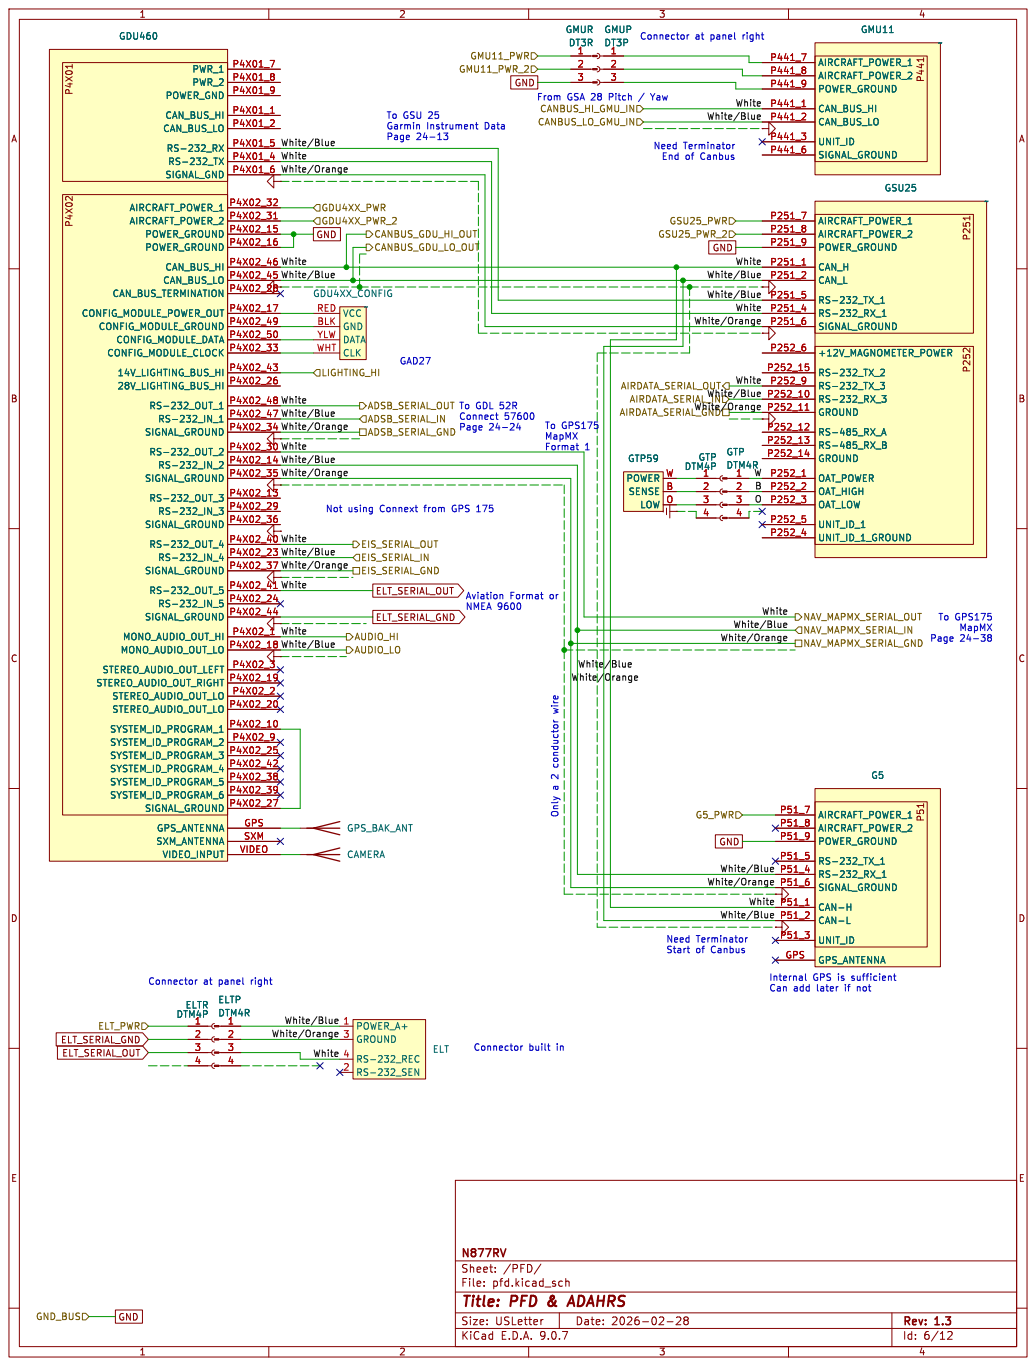
[picture p22: page 6]

Need Terminator End of Canbus To GDL 52R

White White White/Blue BO White/Orange

Need Terminator Start of Canbus

File: pfd.kicad_sch Sheet: /PFD/ N877RV

Id: 6/12 Title: PFD & ADAHRS

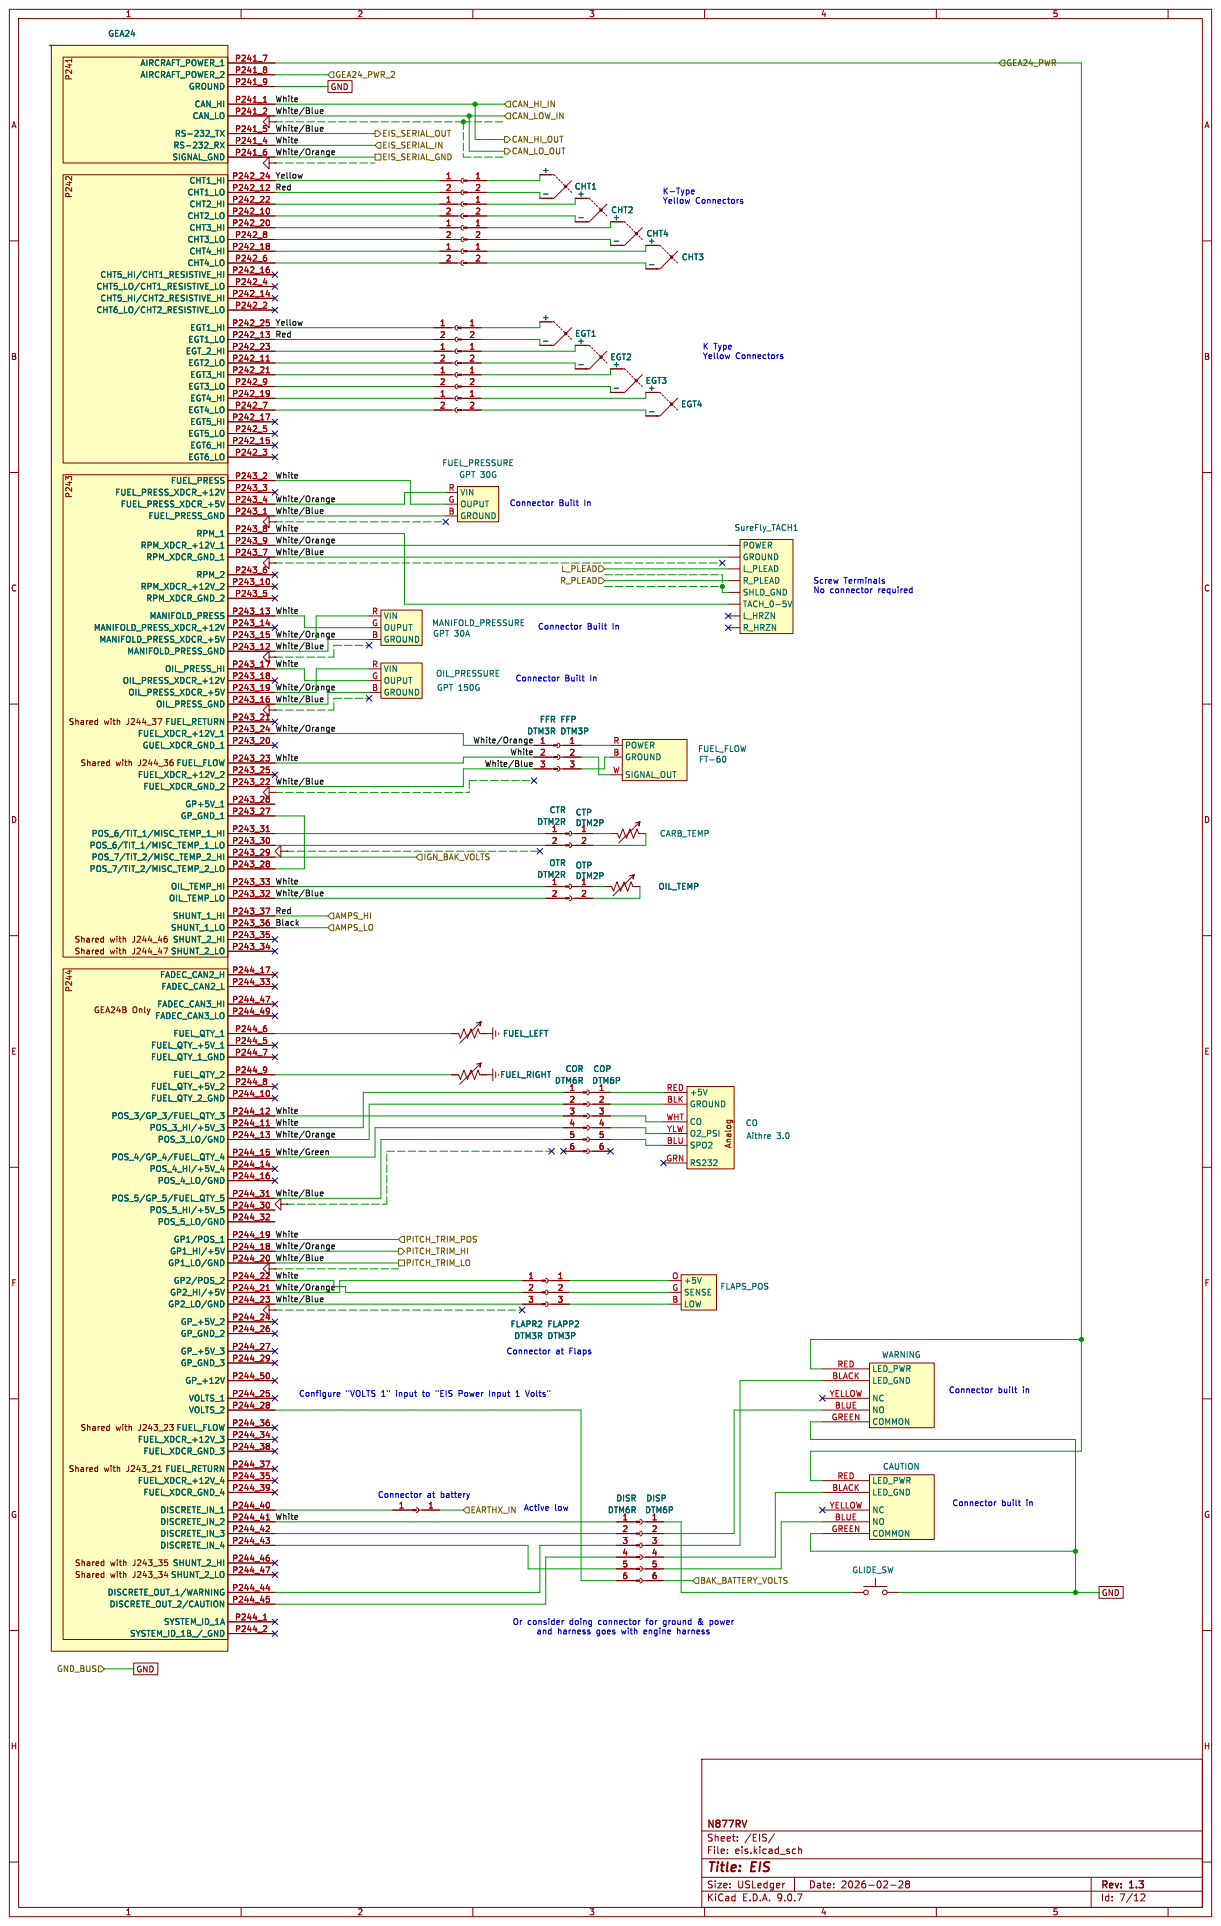
[picture p23: page 7]

White/Blue White/Blue White Red Yellow White/Orange White

White/Orange White/Blue Yellow White/Orange White/Blue Red White

White/Blue White White/Orange White White White/Orange White

White/Blue White White/Orange

GEA24B Only Shared with J244_37
Shared with J244_46 Shared with J244_47 Shared with J244_36

White/Orange White/Blue

File: eis.kicad_sch Sheet: /EIS/ N877RV

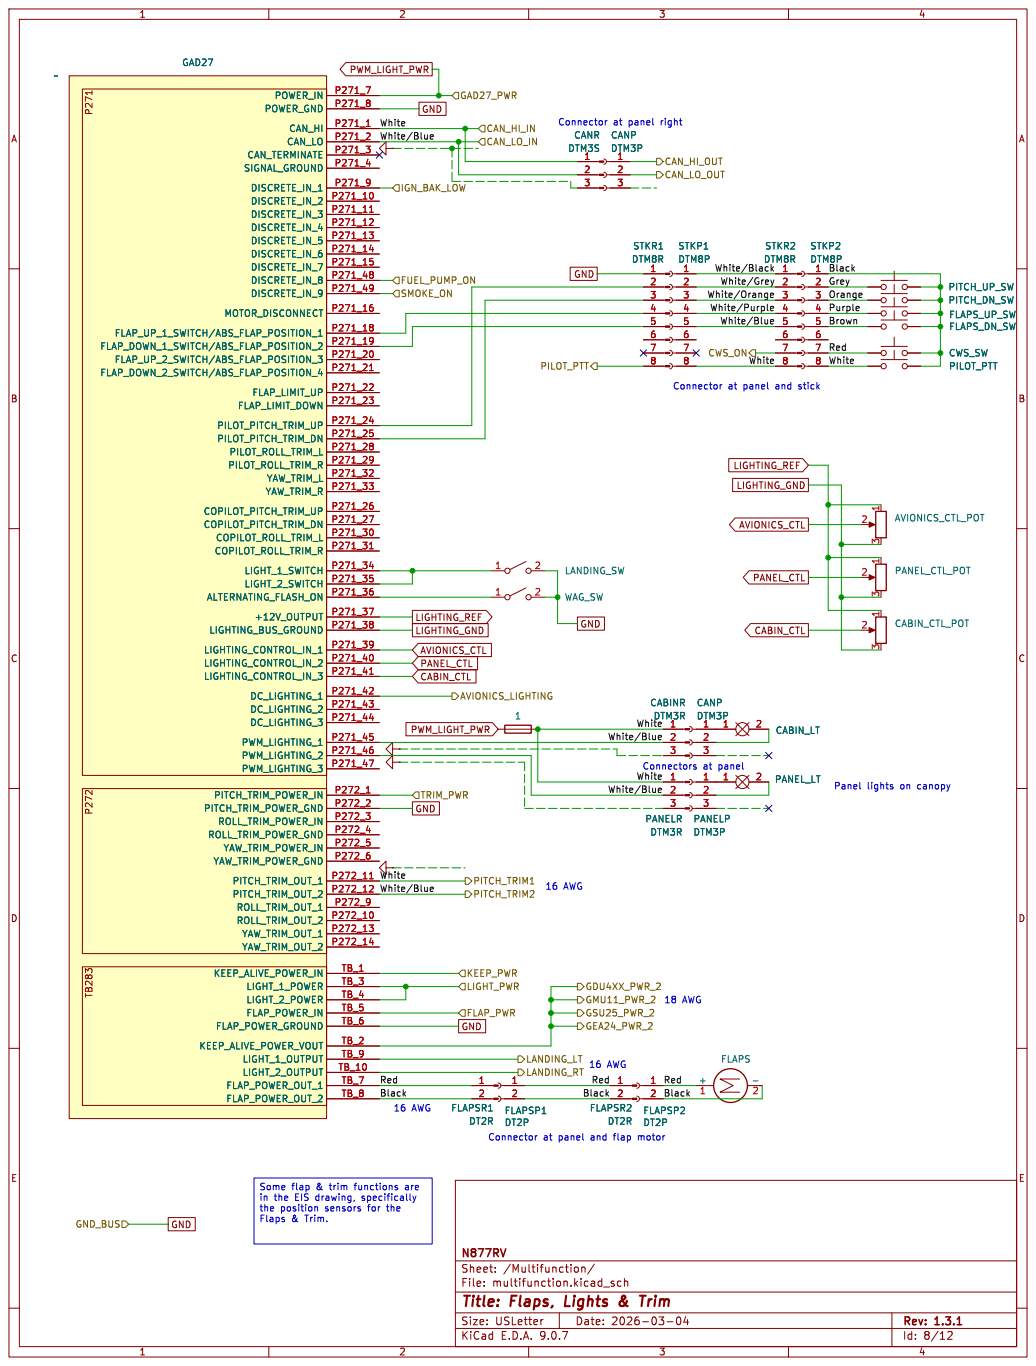
[picture p24: page 8]

Panel lights on canopy

in the EIS drawing, specifically

File: multifunction.kicad_sch Sheet: /Multifunction/ N877RV

Id: 8/12 Title: Flaps, Lights & Trim

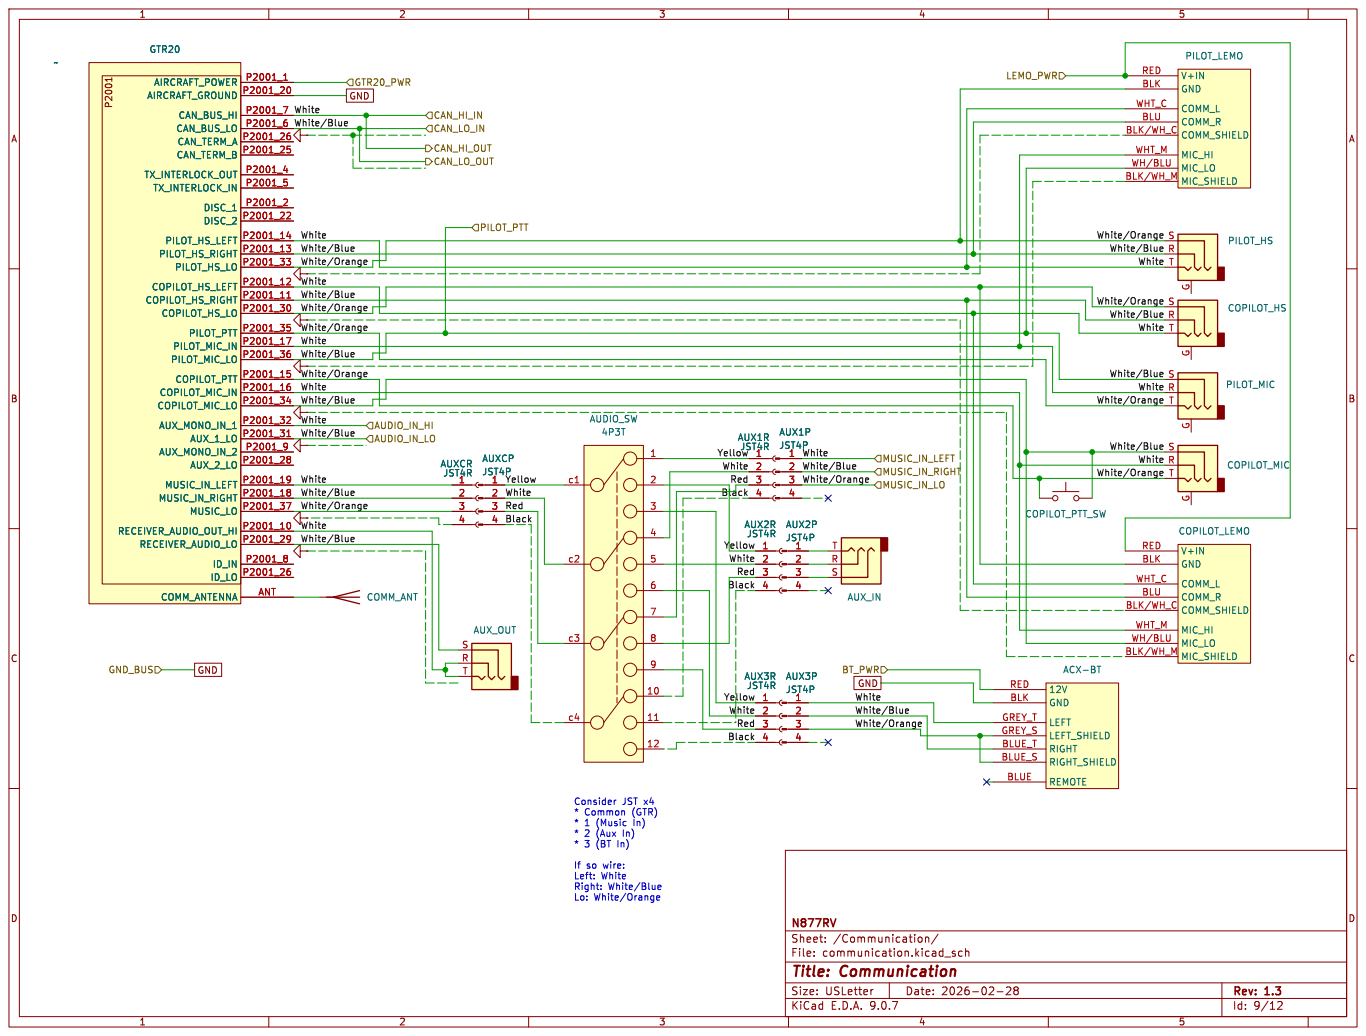
[picture p25: page 9]

* Common (GTR) * 1 (Music In) * 2 (Aux In) * 3 (BT In)

If so wire: Left: White Right: White/Blue

File: communication.kicad_sch Sheet: /Communication/ N877RV

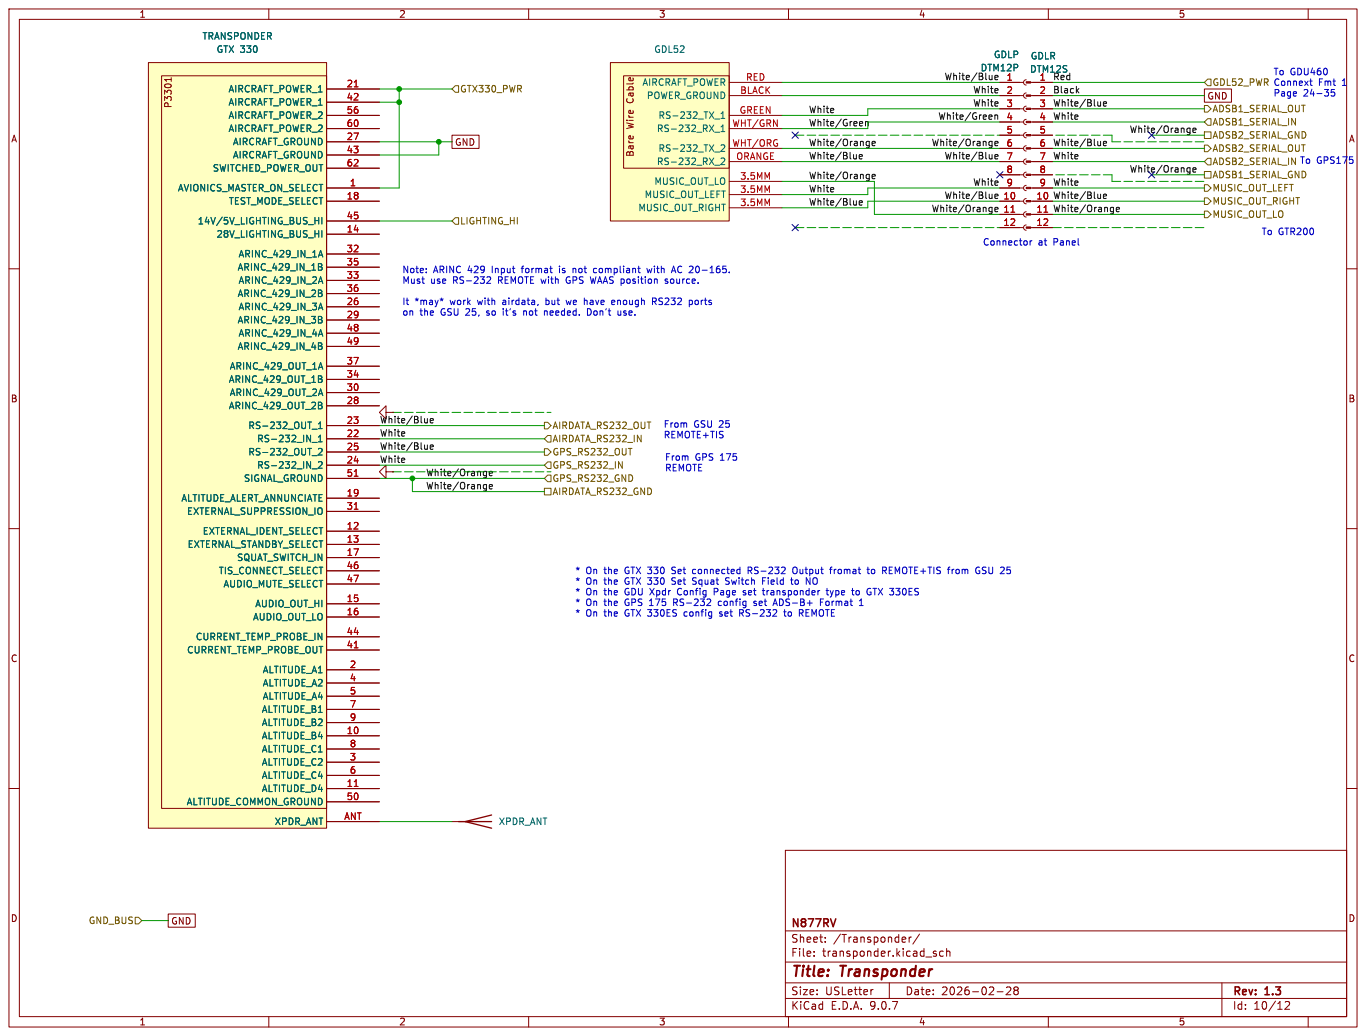
[picture p26: page 10]

* On the GTX 330 Set Squat Switch Field to NO

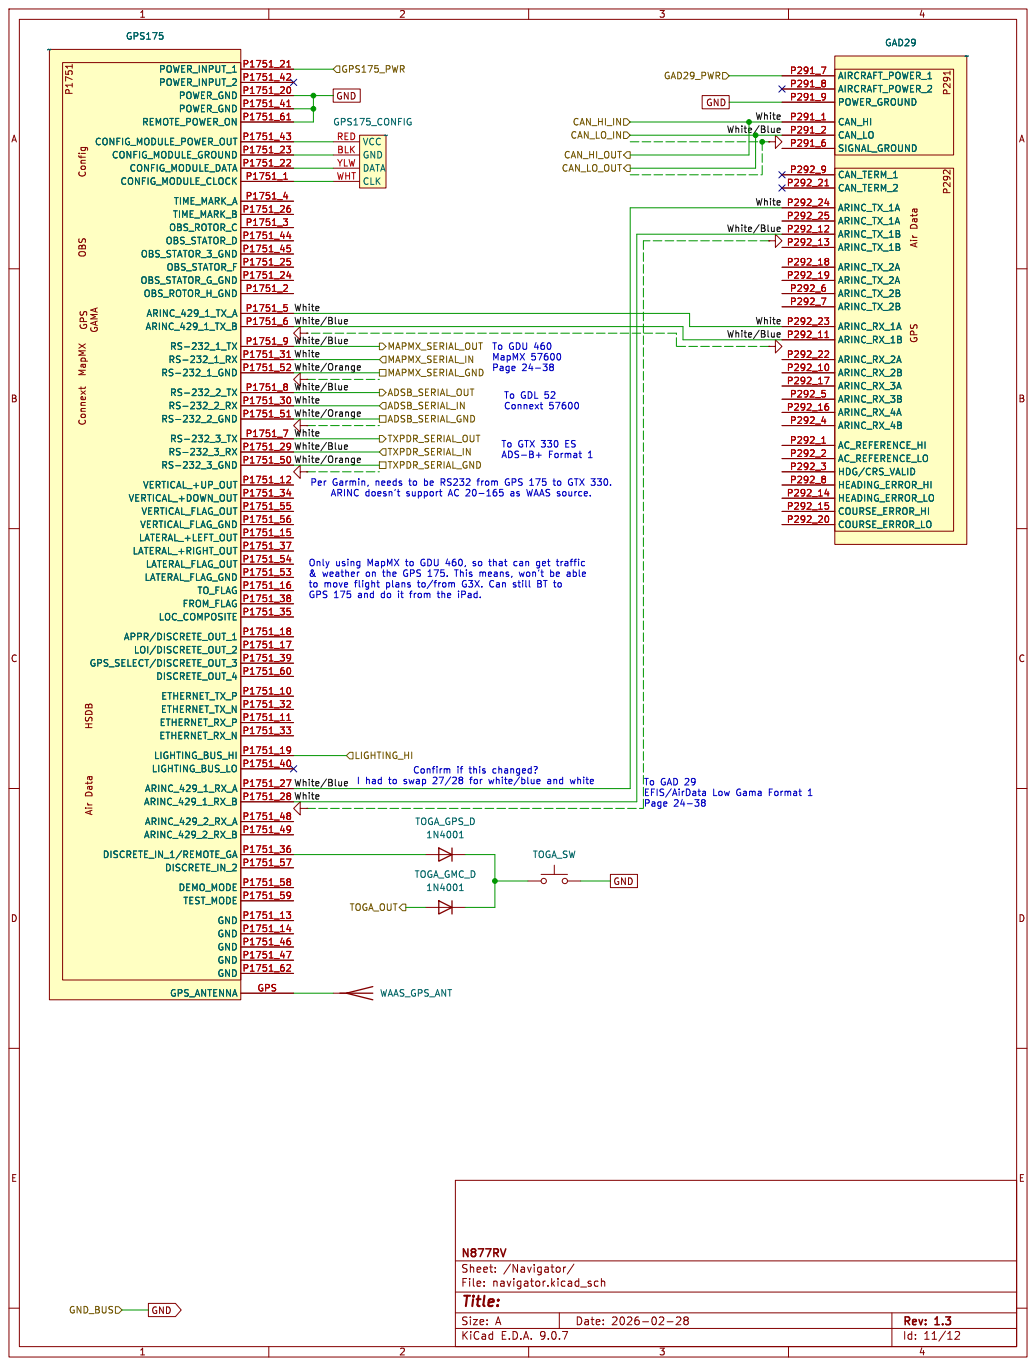
[picture p27: page 11]

1N4001 WAAS_GPS_ANT P1751 Config OBS MapMX Connext GPS

GAMA HSDB Air Data POWER_INPUT_1 P1751_21 POWER_INPUT_2 P1751_42 POWER_GND P1751_20 POWER_GND P1751_41 REMOTE_POWER_ON P1751_61 CONFIG_MODULE_POWER_OUT P1751_43 CONFIG_MODULE_GROUND P1751_23 CONFIG_MODULE_DATA P1751_22 CONFIG_MODULE_CLOCK P1751_1 TIME_MARK_A P1751_4 TIME_MARK_B P1751_26 OBS_ROTOR_C P1751_3 OBS_STATOR_D P1751_44 OBS_STATOR_3_GND P1751_45 OBS_STATOR_F P1751_25 OBS_STATOR_G_GND P1751_24 OBS_ROTOR_H_GND P1751_2 ARINC_429_1_TX_A P1751_5 ARINC_429_1_TX_B P1751_6 RS-232_1_TX P1751_9 RS-232_1_RX P1751_31 RS-232_1_GND P1751_52 RS-232_2_TX P1751_8 RS-232_2_RX P1751_30 RS-232_2_GND P1751_51 RS-232_3_TX P1751_7 RS-232_3_RX P1751_29 RS-232_3_GND P1751_50 VERTICAL_+UP_OUT P1751_12 VERTICAL_+DOWN_OUT P1751_34 VERTICAL_FLAG_OUT P1751_55 VERTICAL_FLAG_GND P1751_56

Id: 11/12 Title: File: navigator.kicad_sch Sheet: /Navigator/ N877RV

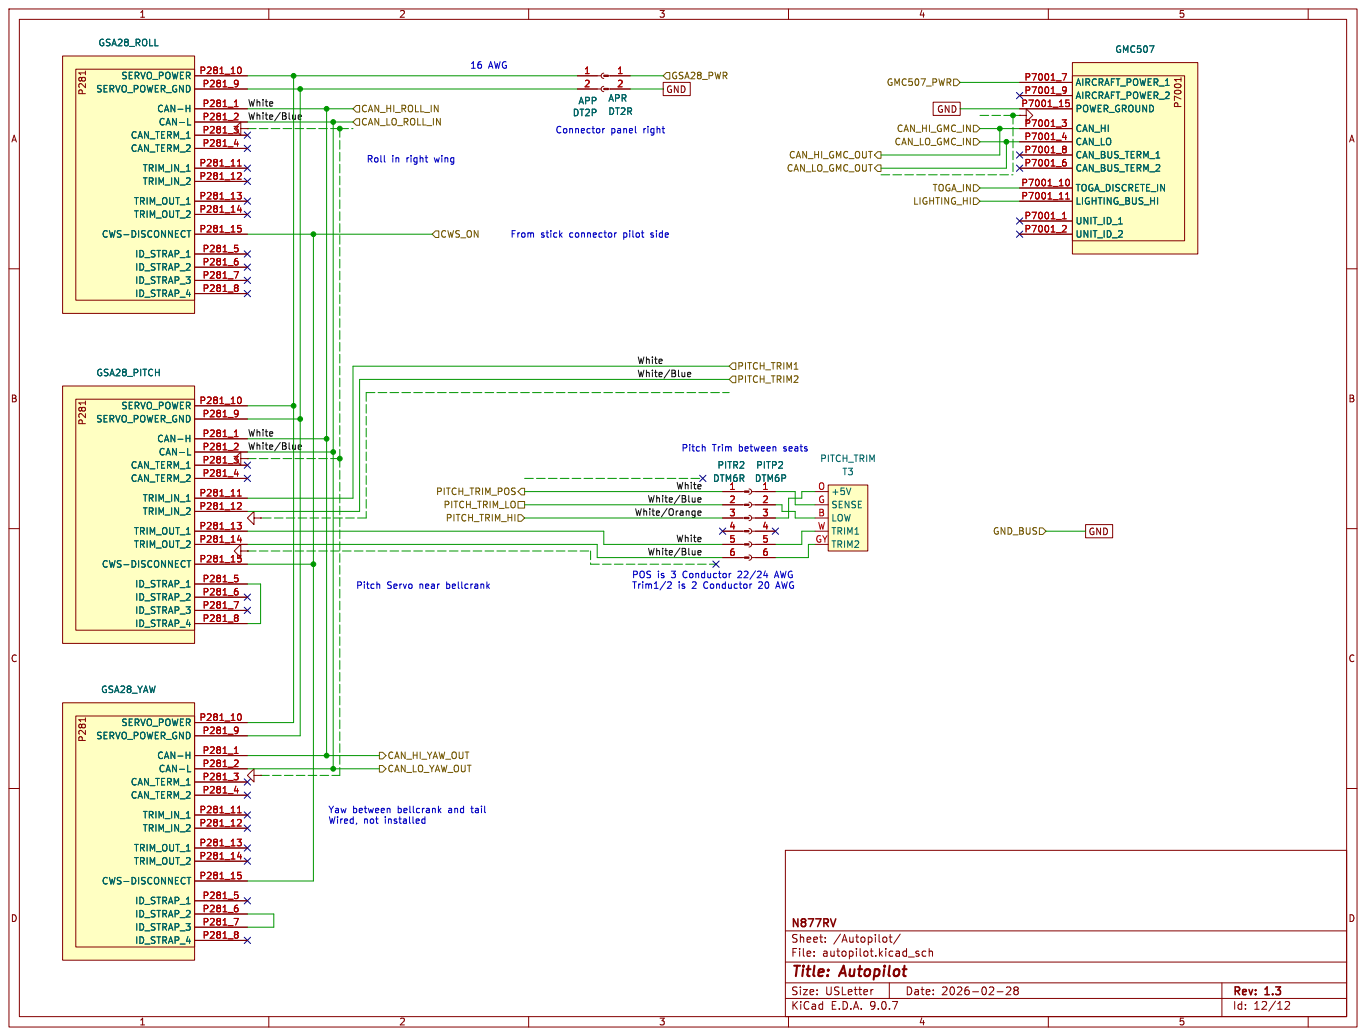
[picture p28: page 12]
