GaryRudolph/N877RV/(commit log)

2024-02-13 First cut at electrical from N915SN.
    [autopilot.kicad_sch, communication.kicad_sch, eis.kicad_sch, electrical.kicad_pcb, electrical.kicad_sch, miscellaneous.kicad_sch, multifunction.kicad_sch, navigator.kicad_sch]
2024-02-13 Added overview
    [autopilot.kicad_sch, communication.kicad_sch, eis.kicad_sch, electrical.kicad_sch, miscellaneous.kicad_sch, multifunction.kicad_sch, navigator.kicad_sch, overview.kicad_sch]
2024-02-14 Added Warning/Caution lights/buttons. Moved smoke on to GAD 27. Added glide button to GAD 27. Added lighting switched pots to GEA 24.
    [eis.kicad_sch, electrical.kicad_sch, multifunction.kicad_sch]
2024-02-14 Updated version and date. Also updated pdf.
    [autopilot.kicad_sch, communication.kicad_sch, eis.kicad_sch, electrical.kicad_sch, miscellaneous.kicad_sch, multifunction.kicad_sch, navigator.kicad_sch, overview.kicad_sch]
2024-02-15 Added V speeds to panel. Added note about backup power & circuit breakers. Changed backup battery circuit breaker size.
    [power.kicad_sch]
2024-02-16 Added smoke light to diagram
    [power.kicad_sch]
2024-02-16 Updated version scheme and printed to PDF
    [autopilot.kicad_sch, communication.kicad_sch, eis.kicad_sch, electrical.kicad_sch, miscellaneous.kicad_sch, multifunction.kicad_sch, navigator.kicad_sch, overview.kicad_sch]
2024-02-17 Made pull handle outline wider, move warning/caution above, added cabin heat, added disclaimers about engine RPM/Manifold for Hartzell limitations.
2024-02-18 Adjusted and verified with CAD.
2024-03-11 Updated electrical to not use IBBS. Also, added BT adapter and 3P3T switch.
    [autopilot.kicad_sch, communication.kicad_sch, eis.kicad_sch, electrical.kicad_sch, multifunction.kicad_sch, navigator.kicad_sch, overview.kicad_sch, pfd.kicad_sch]
2024-04-24 Changed to have ELT with GPS. Also, changed Flaps to have position sensor. Added in wiring for all the sensors.
    [eis.kicad_sch, miscellaneous.kicad_sch, multifunction.kicad_sch, overview.kicad_sch, pfd.kicad_sch, power.kicad_sch]
2024-05-02 Changed GTR CB to 7.5A. Added engine instrumentation. Added signal for fuel on.
    [communication.kicad_sch, eis.kicad_sch, electrical.kicad_sch, multifunction.kicad_sch, power.kicad_sch]
2024-05-07 Updated canbus diagrams with order for where magnometer and servos will be located. Added yaw servo.
    [autopilot.kicad_sch, communication.kicad_sch, eis.kicad_sch, electrical.kicad_sch, miscellaneous.kicad_sch, multifunction.kicad_sch, navigator.kicad_sch, overview.kicad_sch]
2024-05-07 Fixed overview to have yaw servo
    [electrical.kicad_sch, overview.kicad_sch]
2024-05-08 Added Altitude Encoder for 320, also added RS232 air data to Transponder in case upgrade to a GTX 327
    [electrical.kicad_sch, pfd.kicad_sch, power.kicad_sch, transponder.kicad_sch]
2024-05-21 Added AV breaker. Added diodes to TOGA. Moved smoke to use roll trim. Changec cabin & panel to use a single fuse.
    [eis.kicad_sch, electrical.kicad_sch, multifunction.kicad_sch, navigator.kicad_sch, power.kicad_sch]
2024-05-28 Added illustrator based panel for better printing
2024-06-02 Added cables
2025-04-14 Upgraded KiCad
    [autopilot.kicad_sch, communication.kicad_sch, eis.kicad_sch, electrical.kicad_sch, miscellaneous.kicad_sch, multifunction.kicad_sch, navigator.kicad_sch, overview.kicad_sch]
2025-11-19 Interim check-in
    [autopilot.kicad_sch, communication.kicad_sch, eis.kicad_sch, electrical.kicad_sch, lycoming.kicad_sch, miscellaneous.kicad_sch, multifunction.kicad_sch, navigator.kicad_sch]
2025-11-19 Updated from learnings from N78HR
    [autopilot.kicad_sch, communication.kicad_sch, eis.kicad_sch, electrical.kicad_sch, lycoming.kicad_sch, miscellaneous.kicad_sch, multifunction.kicad_sch, navigator.kicad_sch]
2025-12-22 Added Power-Old layer for when we don't have 12V power switch
2025-12-24 Went through and changed a lot from discussions and tradeoffs. Added GTX 330, rmemoved Connext from GDU and added to GPS 175 from GDL 52. Added relay for smoke and to not use GAD 27. Added Tach senso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
    [autopilot.kicad_sch, communication.kicad_sch, eis.kicad_sch, electrical.kicad_sch, lycoming.kicad_sch, miscellaneous.kicad_sch, multifunction.kicad_sch, navigator.kicad_sch]
2025-12-24 Removed unused misc schematic.
    [miscellaneous.kicad_sch]
2025-12-24 Added AWG wires.
    [autopilot.kicad_sch, lycoming.kicad_sch, multifunction.kicad_sch, power.kicad_sch]
2025-12-31 Added other switch treatments
2025-12-31 Added extra connector for GDL 52, rewired stick to have flaps up/down instead of level/smoke. Put smoke on panel.
    [electrical.kicad_sch, multifunction.kicad_sch, power.kicad_sch, transponder.kicad_sch]
2026-01-01 Added beacon and added colors for flaps
    [eis.kicad_sch, lycoming.kicad_sch, multifunction.kicad_sch, power.kicad_sch]
2026-01-04 Assumed engine connector is sufficient for wiring on bench..
    [communication.kicad_sch, eis.kicad_sch, lycoming.kicad_sch, multifunction.kicad_sch, pfd.kicad_sch, power.kicad_sch]
2026-01-06 Made flaps position sensor match colors of POS-12.
    [eis.kicad_sch, power.kicad_sch]
2026-01-06 Added JST connectors as the 4P3T switch is board mount so this will be easier to connect to.
    [communication.kicad_sch, eis.kicad_sch]
2026-01-06 Added connector for discrete buttons on EIS.
    [eis.kicad_sch]
2026-01-06 Adde colors
    [communication.kicad_sch]
2026-01-09 Changed comms PTT and removed shield to TRS plugs. Fixed backwards GDU TX/RX wiring for GSU.
    [communication.kicad_sch, pfd.kicad_sch]
2026-01-09 Placed active high discretes for GAD 27 to pins 8 & 9.
    [multifunction.kicad_sch]
2026-01-09 Cleaned up communications wiring for headphones and mic
    [communication.kicad_sch]
2026-01-09 Fixed polarity on comms connector for aux
    [communication.kicad_sch]
2026-01-09 Fixed version of comms
    [communication.kicad_sch]
2026-01-10 Made notes about POSN+/- for Fly LED. Also, fixed Mic Lo wiring on copilot headset.
    [communication.kicad_sch, power.kicad_sch]
2026-01-12 Fixed colors for Aux In
    [communication.kicad_sch]
2026-01-13 Fixed can hi pin on GTR 20. Changed how ACX-BT wires with low vs. shield. Added pitch trim colors. Removed pitch trim ground going to flaps ground. Removed extra connector on GDL 52 and changed to 4 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
    [autopilot.kicad_sch, communication.kicad_sch, multifunction.kicad_sch, navigator.kicad_sch, transponder.kicad_sch]
2026-01-16 Split Pitch Trim POS to go straight into connector. Changed colors on CO monitor to match what cable had. Changed colors of stick after father changed buttons.
    [autopilot.kicad_sch, eis.kicad_sch, multifunction.kicad_sch]
2026-01-16 Changed GDL to be a 4 wire
    [transponder.kicad_sch]
2026-03-01 Added light power
    [autopilot.kicad_sch, communication.kicad_sch, eis.kicad_sch, electrical.kicad_sch, lycoming.kicad_sch, multifunction.kicad_sch, navigator.kicad_sch, overview.kicad_sch]
2026-03-01 Fixed GDL 52 power color
    [transponder.kicad_sch]
2026-03-01 Fixed trim POS.
    [autopilot.kicad_sch]
2026-03-05 Reverts rename of wing to lights.
    [lights.kicad_sch]
2026-03-05 Wires light switch 2 discrete input into the same landing light switch
    [multifunction.kicad_sch]
2026-08-02 Upgraded G3X Touch to Axis
    [autopilot.kicad_sch, communication.kicad_sch, eis.kicad_sch, electrical.kicad_sch, lights.kicad_sch, lycoming.kicad_sch, multifunction.kicad_sch, navigator.kicad_sch]
2026-08-02 Kept MapMX serial to GDU. It'll just be ignored anyways.
    [pfd.kicad_sch]
2026-08-19 Updated wiring to just do GDU Bat Lead leader. Also, keep pin 31 as effectively backup power like it was on G3X Touch
    [navigator.kicad_sch, pfd.kicad_sch, transponder.kicad_sch]
